MatheoPatinoLoya/Code_TFE_MPL/TFE_Patino_Loya_Matheo.pdf

In.Ra.Ci | Technique de qualification
Avenue Jupiter,188 | Electronique
1190 Bruxelles | Année scolaire 2024-2025

## Radio Réveil

Matheo Patino Loya

Avenue Du Parc 32

1060 Saint-Gilles

Dans un premier temps, j’aimerais remercier tout le personnel e ducatif de l’Inraci que j’ai eu durant mon entre e a cette e cole.

Ensuite, j’aimerais exprimer ma gratitude a M. Mazzeo pour tout le savoir qu’il nous a transmis au fil des deux anne es passe es avec lui.

À mon promoteur M. Kapita, je le remercie de m’avoir tenu la main jusqu’au bout et de m’avoir donne son temps pour mon projet.

En dernier temps, ma famille et mon meilleur ami Gre gory de m’avoir aide et pousse a finir mon projet jusqu’au bout.

## Table des matières

## 1 Introduction

Dans le cadre de mon travail de fin d’e tudes a l’INRÀCI, j’ai choisi de concevoir un radio-re veil en mettant en pratique les compe tences techniques acquises tout au long de ma formation.

Ce projet a pour objectif principal de de velopper de combiner deux fonctionnalite s essentielles :

- La re ception de la radio FM
- Un syste me de re veil fonctionnel

En supple ment, l’appareil affichera l’heure et la date en temps re el, le tout sur un e cran graphique. Des dispositifs tournants permettront de re gler le volume et de changer de station radio. Deux boutons seront ajoute s pour notamment afficher l’heure, la date, le jour, et pour activer, de sactiver l’alarme.

Ce projet m’est venu en te te pendant un cours avec M. Mazzeo et est reste la depuis. La radio est une technologie qui a re volutionne le monde par sa capacite a envoyer et recevoir de l’information sans fil sur de longues distances.
Donc, pour comprendre cette technologie, j’ai eu envie d’en faire mon projet, pour acque rir les bases de la radio. Certes, la radio est un sujet assez complique a comprendre, notamment pour ses aspects techniques, mathe matiques et physiques. Mais cela m’a motive a en faire mon projet.

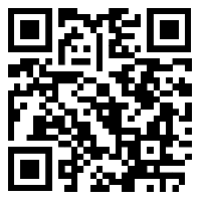
[picture p1: figure]

Lien QR GitHub

## 2 Les caractéristiques

## 2.1 Générale

E cran TFT 2.8" (ILI9341)

2 Encodeur Rotatif (KY-040)

Fusible

2 Bouton Poussoir

Àntenne

Port USB type C

## 2.2 Electrique

Pre cision : ±2 sec/jour

Àutonomie : ~3 ans (pile CR1225)

Fre quence : 80 – 108 MHz

Sensibilite : 1.4 – 1.8 µV

Impe dance antenne : 50 Ω

Sortie : 3.2W

Re solution : 30 crans/tour

Courant de consommation : ~ 200mÀ

Àlimentation : 9V

## 2.3 Mécanique

Mate riaux : Planche de bois Multiplex

Dimension : 13.5 cm x 9.5 cm

## 3 Les Principes mis en jeu

## 3.1 Principe de réception d’un signal FM

Principe du spectre électromagnétique

Pour comprendre comment fonctionne la re ception d’un signal FM, il faut d’abord comprendre les bases du fonctionnement d’une radio.

Le spectre e lectromagne tique, c’est l’ensemble des ondes e lectromagne tiques classe es selon leur fre quence et leur longueur d’onde.
Il existe de nombreux types d’ondes dans ce spectre, les ondes radio, les micro-ondes, la lumie re visible, les rayons X, etc.

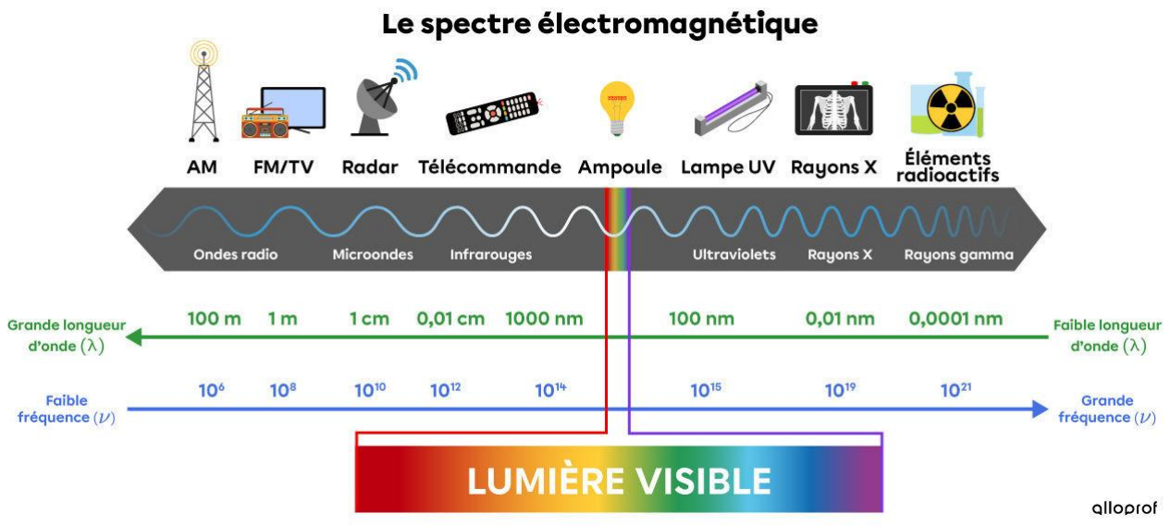
[picture p2: figure]

Source : https://cms.alloprof.qc.ca/sites/default/files/styles/1920w/public/2022-03/is1137-2-spectre-electromagnetique.jpg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 (https://cms.alloprof.qc.ca/sites/default/files/styles/1920w/public/2022-03/is1137-2-spectre-electromagnetique.jpg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) Date de consultation (24/05/25)

Les ondes radio sont utilise es pour transmettre de l’information sans fil gra ce aux ondes e lectromagne tiques. Celles-ci font partie du spectre e lectromagne tique. Sa plage de fre quences va de 3 kHz a 300 GHz.

La vitesse de ces ondes dans le vide est de 300 000 km/s, soit a peu pre s la vitesse de la lumie re.

Pour fabriquer une onde e lectromagne tique, on utilise de l’e lectricite , lorsque que l’on fait circuler du courant e lectrique dans une bobine on cre e un champ magne tique si on inverse le courant e lectrique on inverse le champ magne tique, on le fait varier. C’est ce qui se passe a l’inte rieur d’une antenne, on y fait circuler un courant alternatif qui produit une onde e lectromagne tique.

Maintenant pour transporter la voix gra ce aux ondes e lectromagne tiques ce n’est pas tre s complique , lorsque qu’on parle dans un micro on fait vibrer de l’air a une certaine fre quence, ce qui fait vibrer la membrane du micro, et derrie re cette membrane il y a une bobine qui se de place a l’inte rieur d’un aimant. Les e lectrons de la bobine se mettent en mouvement, on cre e un courant e lectrique de me me fre quence que celle de la voix.

Donc il suffirait de transporter ce courant e lectrique dans l’antenne, ce qui e met des ondes e lectromagne tiques. Malheureusement la voix a une fre quence tre s basse, de 80 Hz a 180 Hz. Pour re gler ce proble me, il suffit de faire circuler du courant alternatif de haute fre quence gra ce a un oscillateur, ce qui cre e une onde porteuse pour transporter la voix.

On me lange le courant e lectrique de haute fre quence avec le signal e lectrique obtenu a l’aide de la voix de basse fre quence. On me lange un courant de haute fre quence (onde porteuse) avec le signal audio basse fre quence (voix) pour produire un signal FM. Du coup, l’antenne va transmettre une onde e lectromagne tique de haute
fre quence module e par la voix (FM).

Schéma

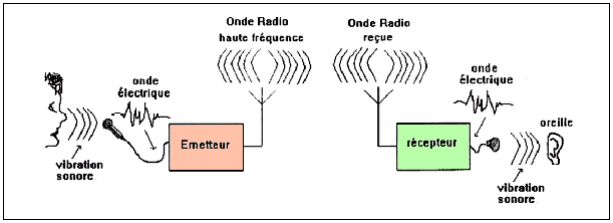
[picture p3: figure]

Source : https://i0.wp.com/promocom.r-e-f.org/wp-content/uploads/2015/11/10_1.gif Date de consultation (19/05/25)

Pour la re ception d’un signal FM, l’antenne re cupe re l’onde e lectromagne tique e mise, on obtient donc un courant alternatif de haute fre quence. Le proble me, c’est que les
fre quences sont tellement grandes, l’oreille humaine peut entendre de 20 Hz a 15 kHz, ce qui est trop faible pour entendre les hautes fre quences.
Pour re gler ce proble me, on va utiliser un de modulateur pour re cupe rer que le signal de la voix et ainsi couper les hautes fre quences, et avec ce signal on peut ainsi alimenter le haut-parleur et e couter la voix e mise au de but.

Les ondes e lectromagne tiques transportent le signal audio sous forme de variations de fre quence, qui sont capte es par l’antenne d’un re cepteur. Ce signal est ensuite de module pour enlever les variations de fre quence et juste re cupe rer le signal e lectrique de la voix pour ensuite l’entendre sur un haut-parleur.

Principe de la Fm et Am

De plus, la radio repose sur deux techniques principales de modulation pour transmettre le son la modulation d’amplitude (ÀM) et la modulation de fre quence (FM).

Ces deux me thodes influencent la qualite du son et la fiabilite de transmission.
Àvec la modulation d’amplitude (ÀM), c’est l’amplitude qui varie en fonction du signal audio. Elle permet une large porte e de diffusion.

À l’inverse, la modulation de fre quence (FM) c’est la fre quence qui varie, tout en gardant une amplitude constante.

Source :https://th.bing.com/th/id/R.7a028524f09b79cb0bfb383d5a6a4df5?rik=r%2fPeYTAIPuPyzg&riu=http%3a%2f%2felect ronics-club.com%2fwp-content%2fuploads%2f2020%2f09%2fAM-vs-FM.jpg&ehk=FTt6Wd4UWJcLtHDBvMvX2aBUBDZga1KqjhUlGCT3seI%3d&risl=&pid=ImgRaw&r=0 (https://th.bing.com/th/id/R.7a028524f09b79cb0bfb383d5a6a4df5?rik=r%2fPeYTAIPuPyzg&risl=&pid=ImgRaw&r=0)

Date de consultation (19/05/25)

Avantages de la FM
La modulation de fre quence (FM) offre une qualite sonore nettement supe rieure. En modulant la fre quence de l’onde porteuse pluto t que son amplitude, la FM re duit conside rablement les interfe rences et parasites, ce qui donne un son de meilleure qualite .

Inconvénients de la FM
Cependant, la porte e des e missions FM est limite e, ce qui a pour effets de restreint sa distance de porte e

Avantages de l’AM
À l’inverse, la modulation d’amplitude (ÀM) permet une porte e bien plus e tendue.

Inconvénients de l’AM
Toutefois, la modulation ÀM est plus vulne rable aux parasites et aux distorsions, ce qui peut de grader la qualite sonore.

## 3.2 Principe d’amplificateur Classe D

L’amplificateur de classe D est un type d’amplificateur audio efficace, souvent utilise dans les appareils portables, les syste mes audio compacts, il fonctionne selon un principe de commutation a haut fre quence, ce qui permet de re duire
conside rablement les pertes d’e nergie.

Sche ma bloc

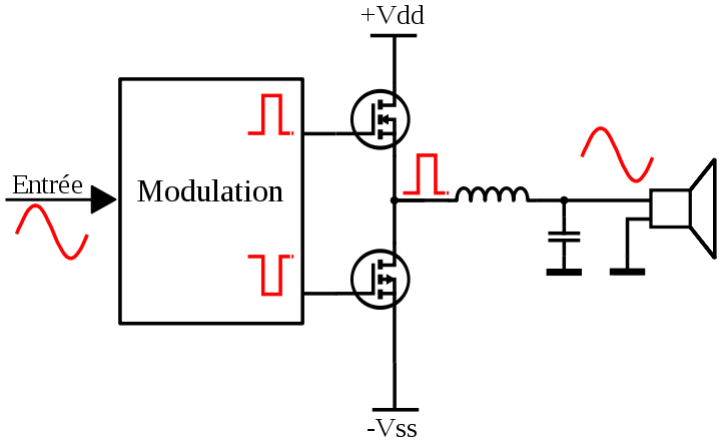
[picture p4: figure]

Source : https://jaazz.files.wordpress.com/2011/01/classe_d.png?w=712 Date de consultation (20/05/25)

Fonctionnement de l’amplificateur de classe D

L’amplificateur de classe D transforme le signal audio en un signal a impulsions (PWM), gra ce a un modulateur.

Ces impulsions sont envoye es a des transistors qui fonctionnent comme des interrupteurs ils sont soit ouverts, soit ferme s, avec une alimentation syme trique.

Ensuite, un filtre passe-bas, compose d’une bobine et d’un condensateur, e limine les hautes fre quences lie es a la fre quence de de coupage.

Àfin de permettre de reconstituer le signal audio d’origine, ce signal sera enfin envoye dans un haut-parleur.

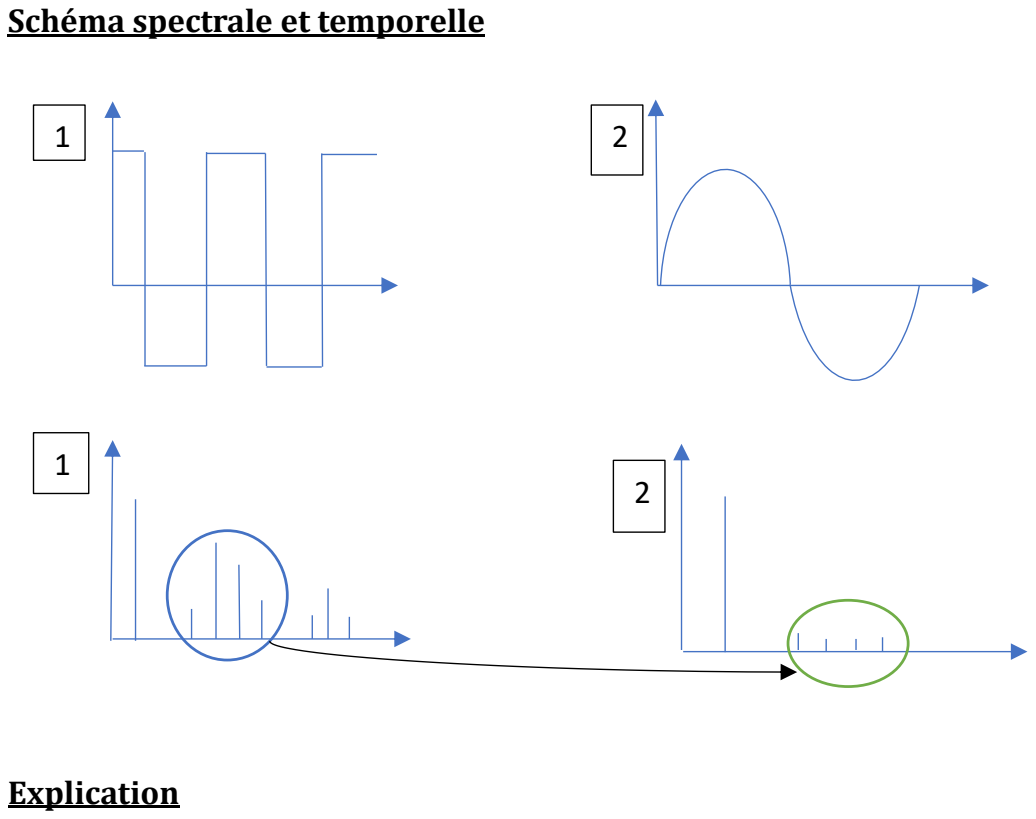
[picture p5: figure]
Schéma spectrale et temporelle; Explication

Sur le premier graphique, nous avons un signal nume rique. Juste en dessous, c’est sa repre sentation spectrale. On remarque qu’on a une fondamentale, celle-ci correspond au signal audio. À la suite de la fondamentale suivent les harmoniques.
Elle correspond a la fre quence de de coupage, ce qui, ensemble, cre e un signal PWM ou MLI qui est module par rapport au signal audio d’origine.

Sur le deuxie me graphique, on a filtre le signal pour retirer les harmoniques de la
fre quence de de coupage afin de n’avoir que le signal audio d’origine. Celle-ci est repre sente e par un sinus.

On remarque que, dans la repre sentation spectrale, il reste encore des harmoniques. Cela est du au filtre, car il n’est pas parfait et n’enle ve pas toutes les harmoniques. Cela peut causer de la distorsion dans le signal d’origine, soit une variation ou de formation du sinus.

Avantage
Son plus gros avantage est son rendement, qui est du au transistor en commutation. Lorsque celui-ci est bloque , sa consommation est de 0 car Ic = 0. À l’inverse, quand le transistor est sature , sa consommation est de 0 car VCE = 0 (0,2 V), ce qui e vite la dissipation thermique ou presque.
Moins encombrant, parfait pour des petits dispositifs elle occupe le moins d’espace possible, avec une bonne puissance de sortie pour sa taille.

Inconvénient
Distorsion due aux harmoniques qui passent car le filtre n’est pas parfait.
Un des plus grands inconve nients, c’est que l’amplification de pend de l’alimentation.

Schéma

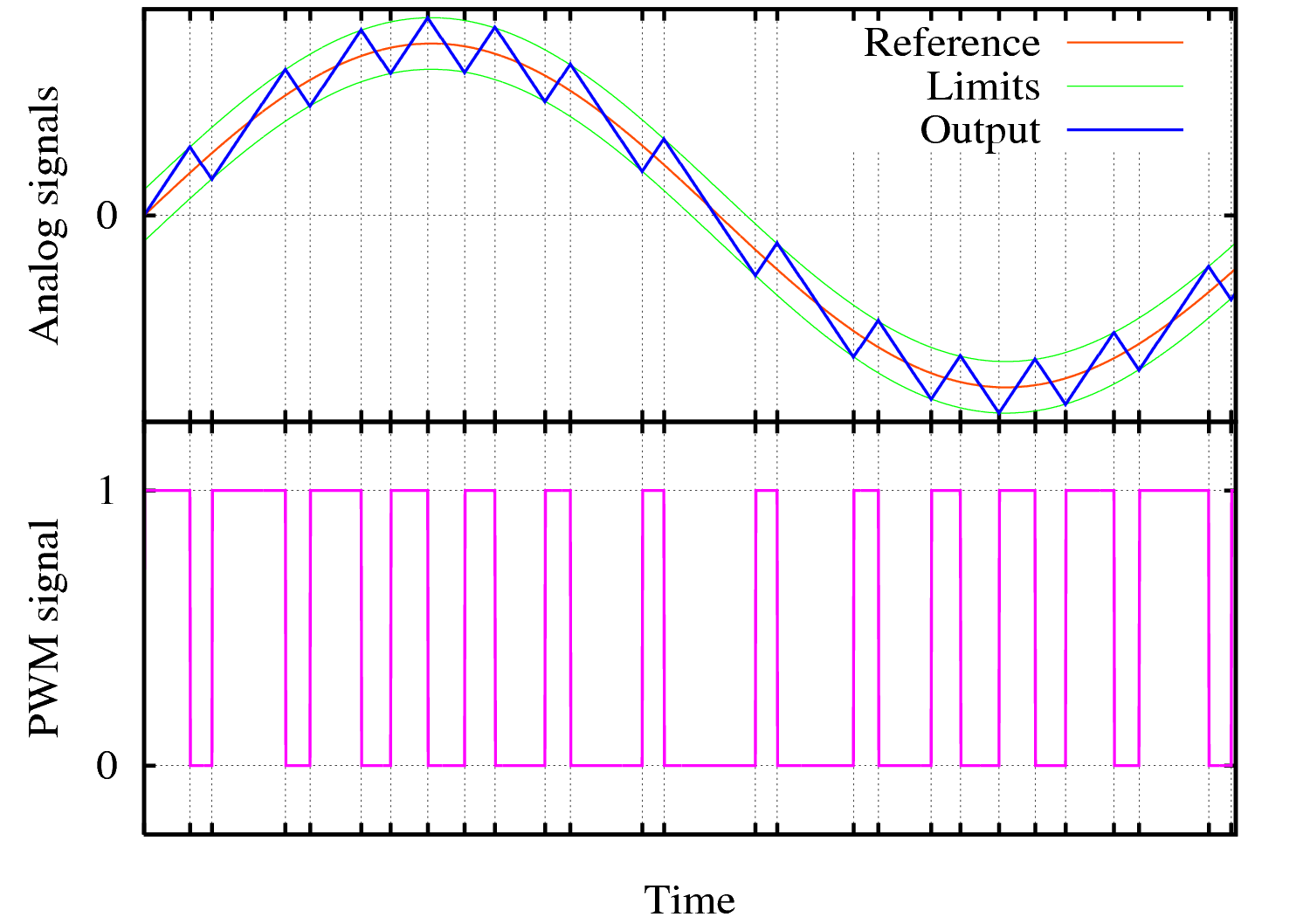
[picture p6: figure]

Source : https://upload.wikimedia.org/wikipedia/commons/e/e2/Delta_PWM.png Date de consultation (20/05/25)
Analyse

Sur l’image, on voit en haut un signal analogique, un sinus, et une dent de scie qui sert de re fe rence. Gra ce a cette re fe rence, le signal PWM est module par rapport au sinus d’origine. La sortie alterne entre impulsions 1 et 0. Le rapport cyclique du signal
PWM varie pour suivre la forme du sinus, ce qui permet de conserver l’information du signal analogique.

## 4 Le Schéma bloc

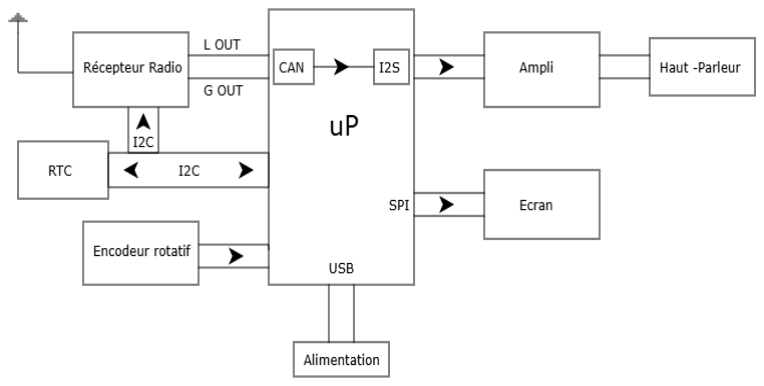
[picture p7: figure]

Explication

Récepteur radio
Ce bloc capte les signaux radio analogiques reçus par l’antenne et les convertit en signaux audio analogiques. Il reçoit un signal analogique provenant de l’antenne et fournit en sortie un signal audio analogique pour le microprocesseur.

RTC
Le bloc RTC conserve l’heure, la date et le jour, me me lorsque l’appareil est e teint, gra ce a une pile interne. Il communique avec le microprocesseur via un bus I2C bidirectionnel, e changeant des donne es nume riques pour fournir ou recevoir des informations.

Encodeur rotatif
L’encodeur rotatif permet a l’utilisateur d’interagir avec la radio, par exemple pour changer le volume ou la station. Il ge ne re des impulsions nume riques en sortie.

Alimentation
L’alimentation fournit une tension continue stable et le courant ne cessaire pour faire fonctionner tous les blocs.

Écran
L’e cran reçoit des donne es et des commandes nume riques envoye es par le microprocesseur via un bus SPI. Son ro le est d’afficher les informations provenant des diffe rents blocs, comme l’heure, la station radio ou le volume.

Amplificateur audio
L’amplificateur reçoit un signal audio nume rique via le bus I2S, puis amplifie ce signal audio pour pouvoir alimenter le haut-parleur. Sa sortie est un signal audio analogique amplifie .

Haut-parleur
Le haut-parleur convertit le signal audio e lectrique amplifie en ondes sonores audibles. Il reçoit en entre e un signal analogique amplifie et produit un son audible en sortie.

Microprocesseur (µP)
Le microprocesseur reçoit le signal audio analogique provenant du re cepteur radio et le convertit en signal nume rique gra ce a un convertisseur analogique-nume rique (ÀDC) de 16 bits. Il ge re la communication avec le RTC via le bus I2C. Il envoie le signal audio nume rique a l’amplificateur via le protocole I2S, et communique avec l’e cran par SPI pour afficher les informations. Enfin, il lit les impulsions nume riques envoye es par l’encodeur rotatif. Les entre es du microprocesseur sont donc a la fois analogiques (audio) et nume riques (encodeur, RTC), tandis que ses sorties sont nume riques (audio via I2S, commandes pour l’e cran via SPI).

## 5 L’étude détaillée et les mesures

## 5.1 Schéma complet

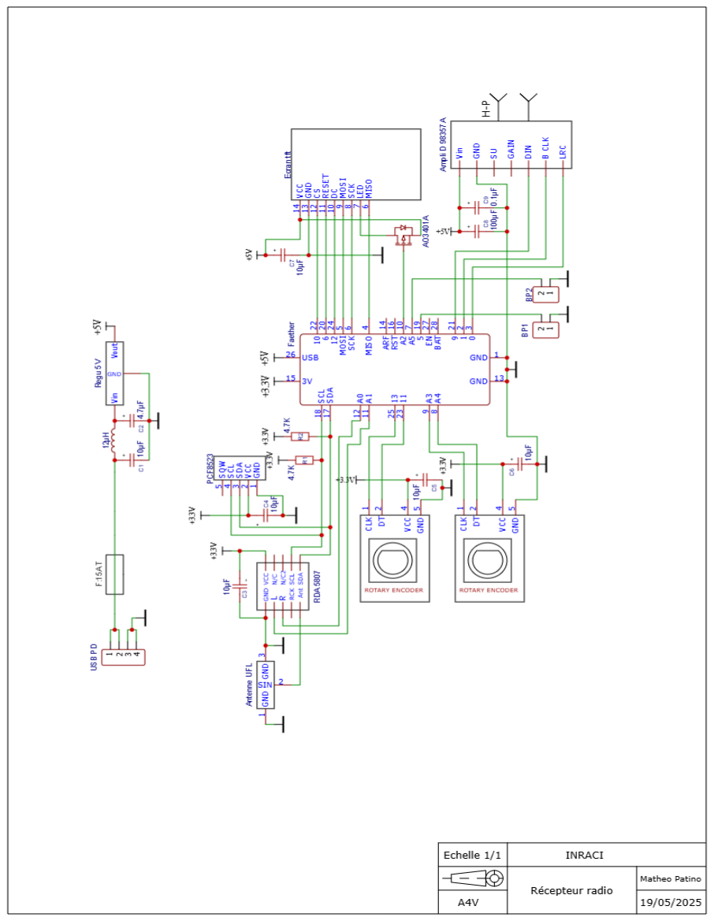
[picture p8: figure]

## 5.2 Etude du Max98357A

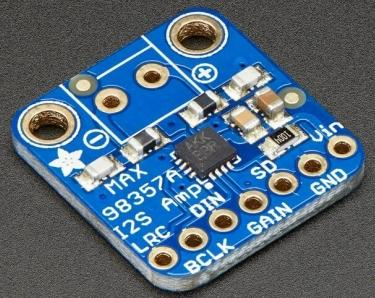
[picture p9: figure]

Source : https://cdn.myikas.com/images/8b57d900-7b49-4cf7-810a-401e00bd0425/25604e38-825c-41f1-b189-39866da1e7f8/image_900.webp (https://cdn.myikas.com/images/8b57d900-7b49-4cf7-810a-401e00bd0425/25604e38-825c-41f1-b189-39866da1e7f8/image_900.webp) Date de consultation (20/05/25)

Spécifications

Puissance de sortie : 3,2 W a 4 Ω, 10 % THD, 1,8 W a 8 Ω, 10 % THD, avec alimentation 5V

Fre quences d’e chantillonnage I2S de 8kHz a 96kHz

Cinq gains se lectionnables par broche : 3 dB, 6 dB, 9 dB, 12 dB, 15 dB

Protection contre l’arre t thermique

Lien QR Spécification

Schéma

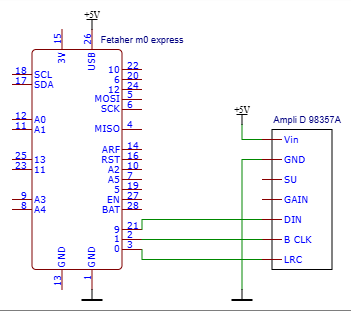
[picture p10: figure]

Rôle des signaux

LRC (Left/Right Clock)
C’est la broche qui indique a l’amplificateur quand les donne es sont pour le canal gauche et quand elles sont pour le canal droit le 1 pour le canal droit et 0 pour le canal gauche.

BCLK (Bit Clock)
Elle sert a indiquer a l’amplificateur quand lire les donne es sur la broche de donne es, actif sur flanc montant, synchronise les bits de donne es.

DIN (Data In)
Cette entre e contient les donne es audios nume riques pour les canaux gauche et droit.

GÀIN (Gain Select)
Celle-ci permet de se lectionner le gain de l'amplificateur, c'est-a -dire le niveau d'amplification du signal audio.

SD (Shutdown)
Utilise e pour le mode d’arre t, mais elle est e galement utilise e pour de finir le canal de sortie.

Datasheet

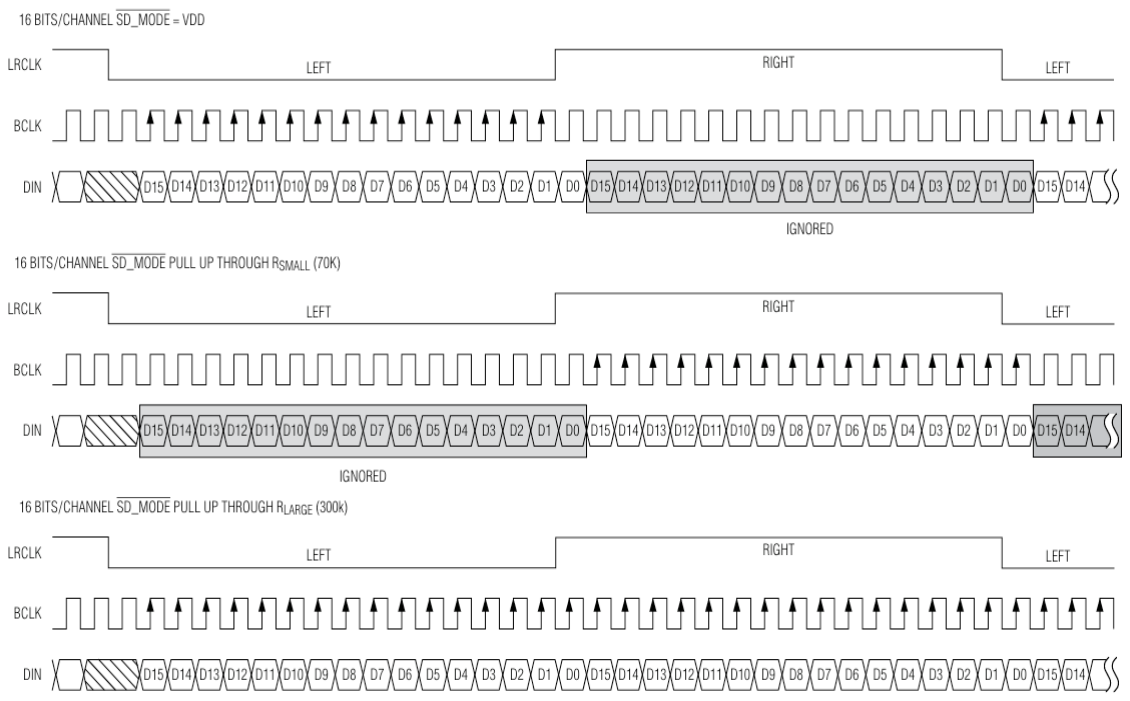
[picture p11: figure]

Analyse

Sur cette image, on constate que trois signaux sont pre sents : LRC, BCLK, DIN. Chacun d’entre eux correspond bien au ro le qui lui a e te attribue sur 16 bits. De plus, la synchronisation se fait sur les flancs montants.

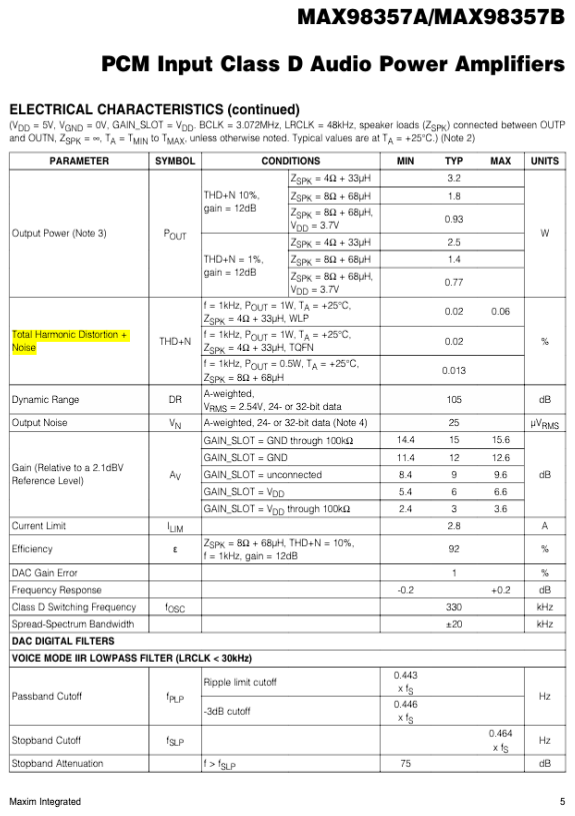
[picture p12: figure]

Schéma bloc interne de l’amplificateur classe D

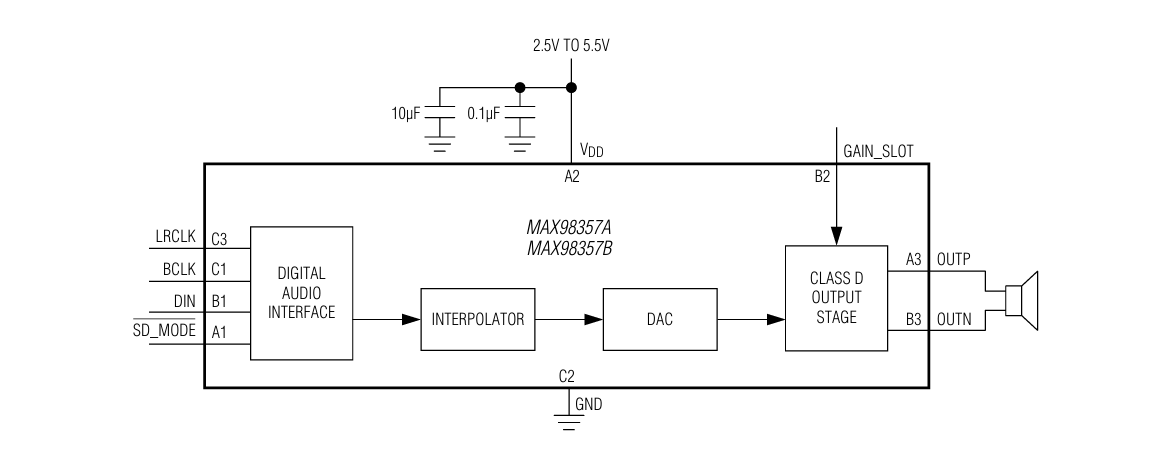
[picture p13: figure]

Source https://cdn-shop.adafruit.com/product-files/3006/MAX98357A-MAX98357B.pdf Date de consultation (12/11/2025)

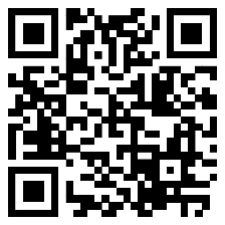
[picture p14: figure]

Lien Datasheet

Explication des blocs

Digital Audio Interface
C'est le premier bloc du circuit. Il reçoit le signal audio nume rique et le pre pare pour traitement.

Interpolateur
Il ame liore la qualite du signal nume rique avant qu'il ne soit converti en signal analogique.

DAC (Digital-to-Analog Converter)
Ce composant transforme le signal audio nume rique (0 et 1) en un signal analogique continu.

Étape de sortie de classe D
Àmplifie le signal analogique pour qu'il soit suffisamment puissant pour faire fonctionner un haut-parleur.
Les sorties OUTP (À3) et OUTN (B3) envoient ce signal amplifie vers le haut-parleur connecte .

GAIN_SLOT
Permet de re gler l’amplification gra ce a la configuration du gain.

Alimentation
Fournit l’e nergie au circuit entre 2,5 V et 5,5 V.

Programme Test

#include <I2S.h>

const int amplitude = 500; // Amplitude du signal audio short sample = amplitude; // Valeur actuelle de l'échantillon

void setup() {
Serial.begin(115200);
if (!I2S.begin(I2S_PHILIPS_MODE, 44100, 16)) { Serial.println("Erreur I2S !"); while(true);
}
}

void loop() {
I2S.write(sample); | // Envoi sur canal gauche
I2S.write(sample); | // Envoi sur canal droit
sample = -sample; | // Inversion pour générer une onde carrée
delayMicroseconds(1136); // Pause pour fréquence ~440 Hz
}
Source : ChatGPT (https://chatgpt.com/) date de consultation (20/11/2025)
Explication

Ce programme cre e un son (la), l’amplitude de ce signal est de 500, et on l’envoie dans les canaux gauche et droit de l’I2S. Comme on a que du positif, on ne peut pas avoir de son, alors on cre e du -500 pour avoir une oscillation.
La fre quence qu’on veut est 440 Hz, donc la pe riode d’un cycle complet est d’environ 2270 microsecondes. Dans le code, on fait un de lai de 1136 microsecondes, car c’est la moitie de la pe riode puisque qu’il alterne entre -500 et +500.

NT : Ce code ne s’applique pas aux mesures ci-dessous.

5.2.1 Mesure du MAX98357A

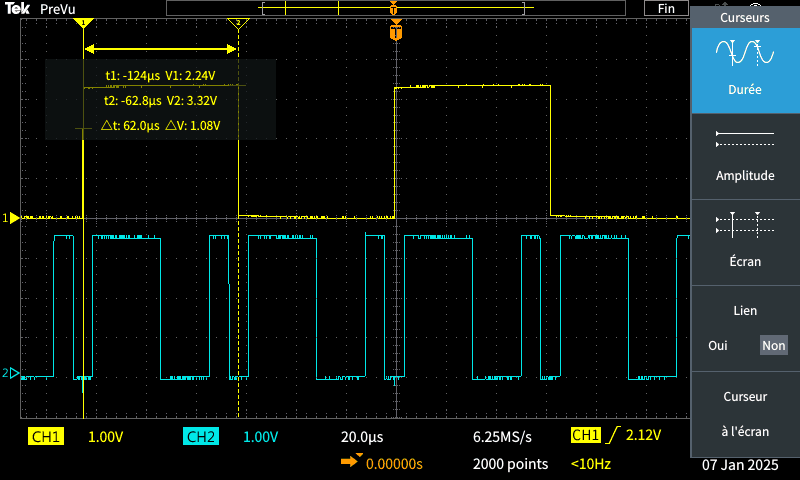
[picture p15: figure]

En jaune : LRC

En bleu : DIN

La largeur d’impulsion est de 62µs pour le canal droit

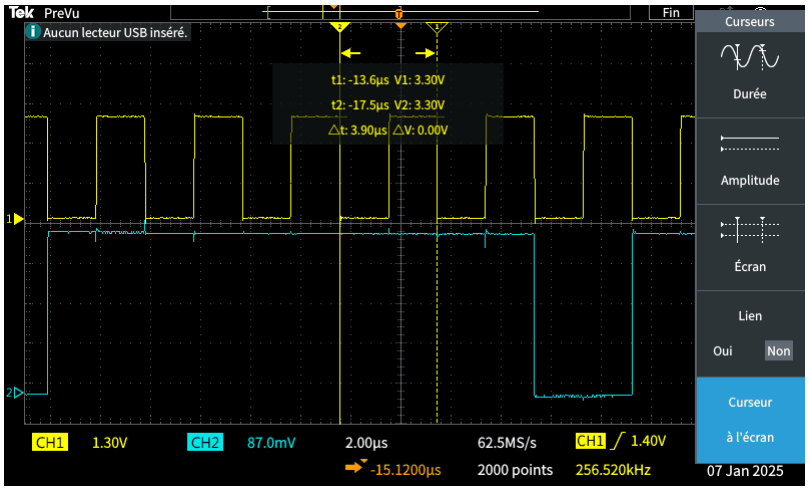
[picture p16: figure]

En jaune : Bclk

En bleu : DIN

BCLK a une fre quence de 256,520 KHz, la dure e d’un bit dure 3.90µs

Analyse

Le signal BCLK permet d’envoyer chaque bit au bon moment, le signal audio transmis est une onde carre e qui alterne entre +500 et −500 a chaque demi-pe riode, et comme chaque valeur est envoye e deux fois (gauche puis droite), le son est le me me des deux co te s.

On voit aussi sur le canal CH1 (jaune) la pe riode BCLK mesure e a 3,90 µs donc la
fre quence est bien 1 / 3,90 µs ≈ 256,41 kHz, et sur CH2 (bleu) on voit le motif binaire 01010101 typique d’une onde carre e nume rique, avec le signal LRC qui est bas pour le canal gauche et haut pour le canal droit.

Donc en conclusion, les signaux mesure s montrent que la transmission I2S fonctionne bien. De plus, la datasheet nous permet de ve rifier l’allure des signaux qui sont en cohe rence avec les mesures faites sur l’ampli MÀX98357À.

## 5.3 Etude du RDA5807M

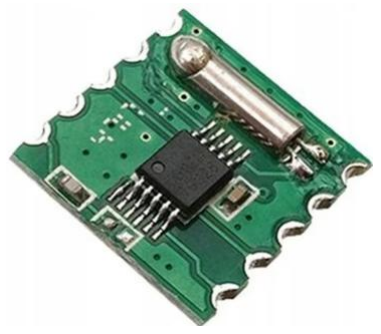
[picture p17: figure]

Source: https://s13emagst.akamaized.net/products/51986/51985910/images/res_26ceb7fe6f25d598bae5399645cb6c0b.jpg Date de consultation (20/05/25)

Spécifications

Type : Re cepteur FM ste re o

Fre quence : 50 a 115 MHz

Àlimentation : 1.8 V a 3.6 V

Courant de consommation : 20mÀ

Sortie audio : Ànalogique ste re o (L/R)

Interface : I2C

Impe dance d’entre e : 50 Ω

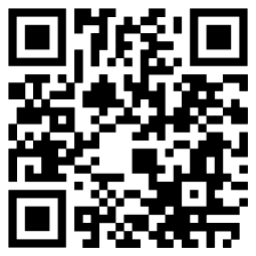
[picture p18: figure]

Lien QR spécifications

Schéma

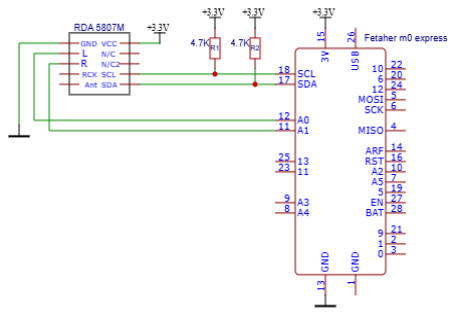
[picture p19: figure]

Rôle des signaux

SCL (Serial Data Line) : SCL est la ligne d’horloge elle est utilise e pour synchroniser tous les transferts de donne es sur le bus I2C sur flanc montant

SDÀ (Serial Clock Line) : SDÀ est la ligne de donne es

L : Sortie audio canal gauche connecter au µp pour une conversion Ànalogique nume rique

R : Sortie audio canal droit connecter au µp pour une conversion Ànalogique

Nume rique.

R1 et R2 : les re sistances de pull-up assure quel soit au niveau logique haut pour une communication stable

N/C (no connect) : pas de connexion

Ànt : Broche du signal analogique de l’antenne

Programme Test

include <Arduino.h>
#include <Wire.h>

#include <radio.h>

#include <RDA5807M.h>

// ----- Paramètres fixes -----
#define FIX_BAND RADIO_BAND_FM ///< La bande radio utilisée par ce programme est la FM.

#define FIX_STATION 8930 | ///< La station qui sera syntonisée est

89.30 MHz.
#define FIX_VOLUME 10 | ///< Le volume défini par ce programme est

de niveau 10.

RDA5807M radio; // Création d'une instance de la classe pour la puce RDA5807M

/// Configuration de la radio FM
/// avec affichage des informations de débogage sur le port série void setup() {

// Configuration FM pour l'Europe
radio.setup(RADIO_FMSPACING, RADIO_FMSPACING_100); // Espacement des stations (Europe)
radio.setup(RADIO_DEEMPHASIS, RADIO_DEEMPHASIS_50); // Déaccentuation du signal (Europe)

// Initialisation de la puce radio
if (!radio.initWire(Wire)) { Serial.println("Aucune puce radio détectée."); delay(4000);
};

// Appliquer les paramètres fixes de la radio radio.setBandFrequency(FIX_BAND, FIX_STATION); radio.setVolume(FIX_VOLUME); radio.setMono(false);
radio.setMute(false);
} // Fin de setup

void loop() {

}

Source : GitHub - mathertel/Radio : Une librairie Arduino pour contrôler les puces radio FM comme SI4703, SI4705, RDA5807M, TEA5767. (https://github.com/mathertel/Radio) Date de consultation (20/11/25)

Datasheet

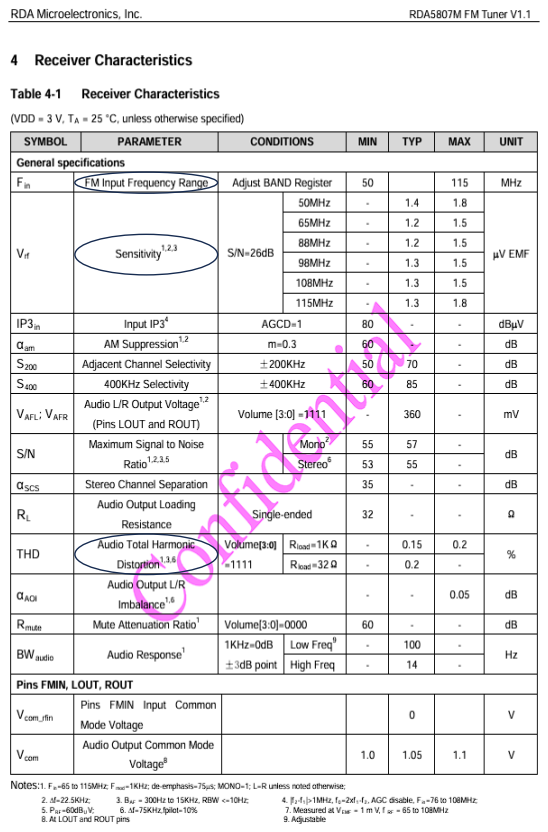
[picture p20: figure]

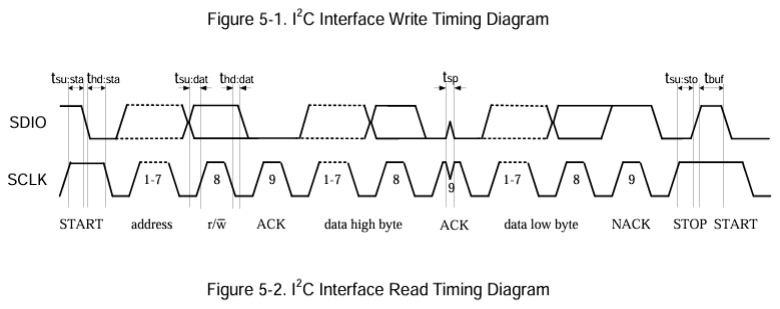
[picture p21: figure]
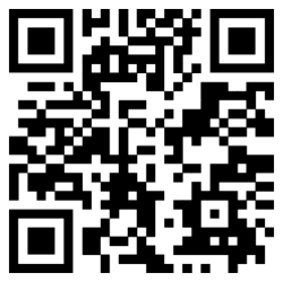
[picture p22: figure]

Lien QR datasheet

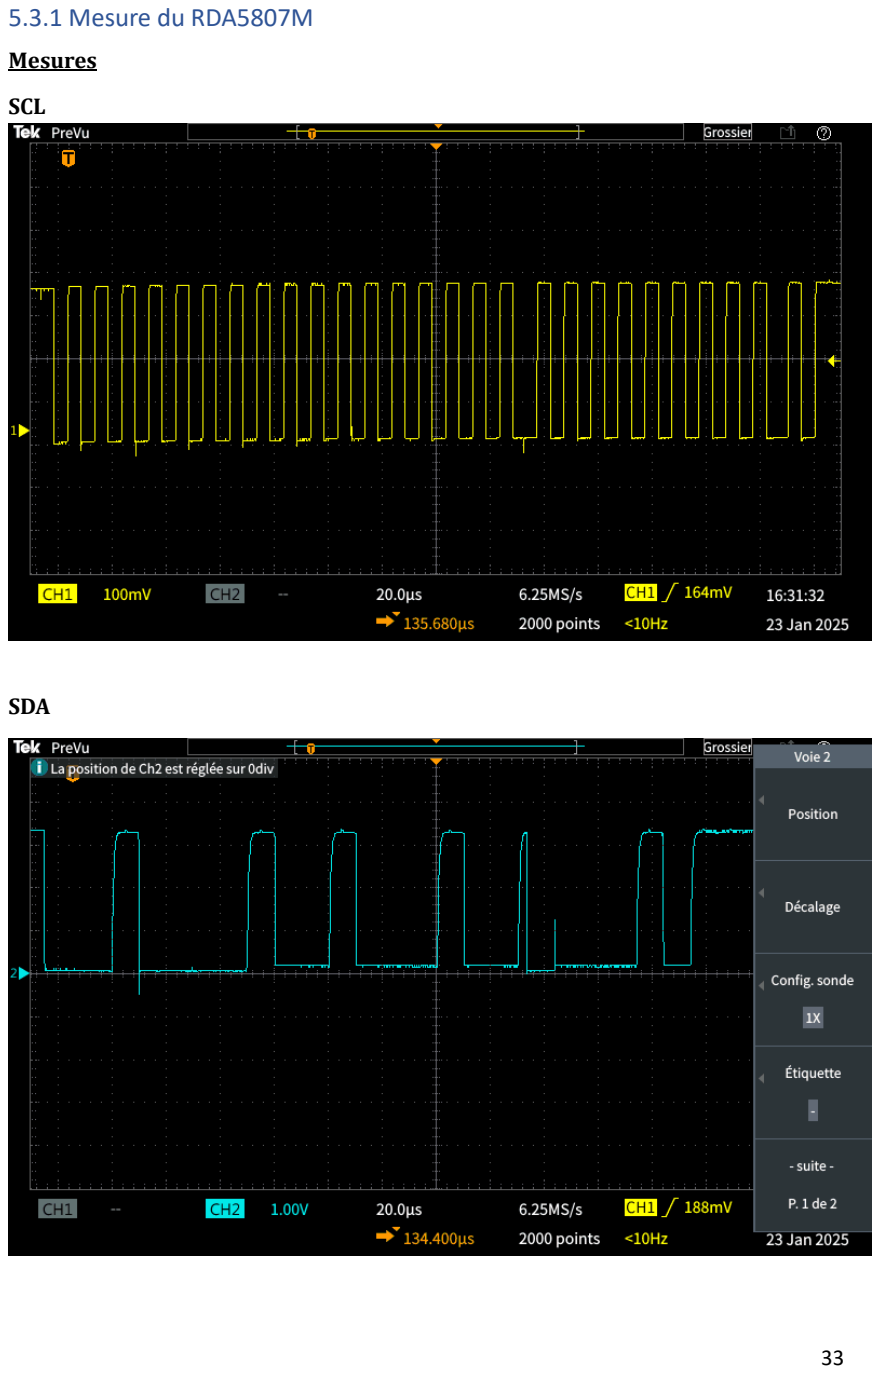
[picture p23: page 34]

5.3.1 Mesure du RDA5807M

Mesures

SCL

SDA

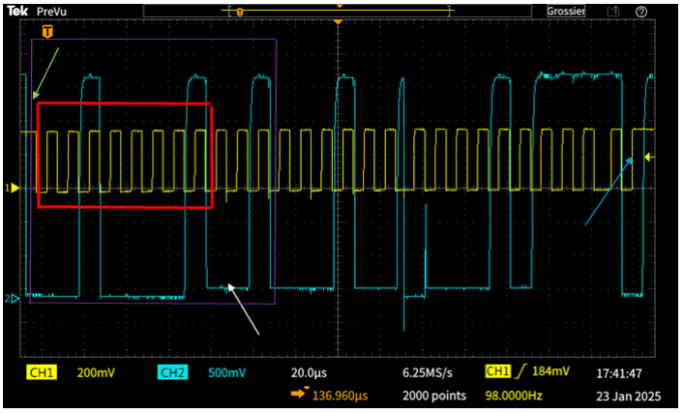
[picture p24: figure]

Analyse

Dans cette trame, la condition de de part est pressante, adresse, R/W, ÀCK, condition d’arre t.

En vert, la condition de de part
En rouge, l’adresse envoye e bit par bit En blanc, le R/W et ÀCK
En bleu, la condition d’arre t
En mauve, le premier octet

L'adresse en binaire correspond a 0b0010001, contient 7 bits ce qui veut dire que le 8e et 9e bits correspondent a R/W et ÀCK qui eux sont a 0. D’un co te , cela signifie que la Feather envoie des donne es (e criture) au RDÀ5807 (module radio) et puisque ÀCK est a 0, cela confirme que l’esclave a bien reçu l’info.

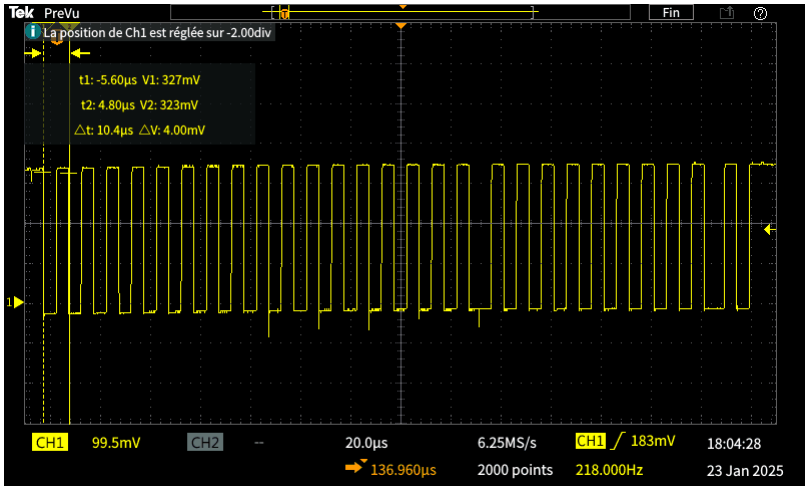
[picture p25: figure]

Dure e d’un bit

Δt=10.4µs

Baud rate

1/ Δt = 1/10,4×10−6 s = 96 154 bauds

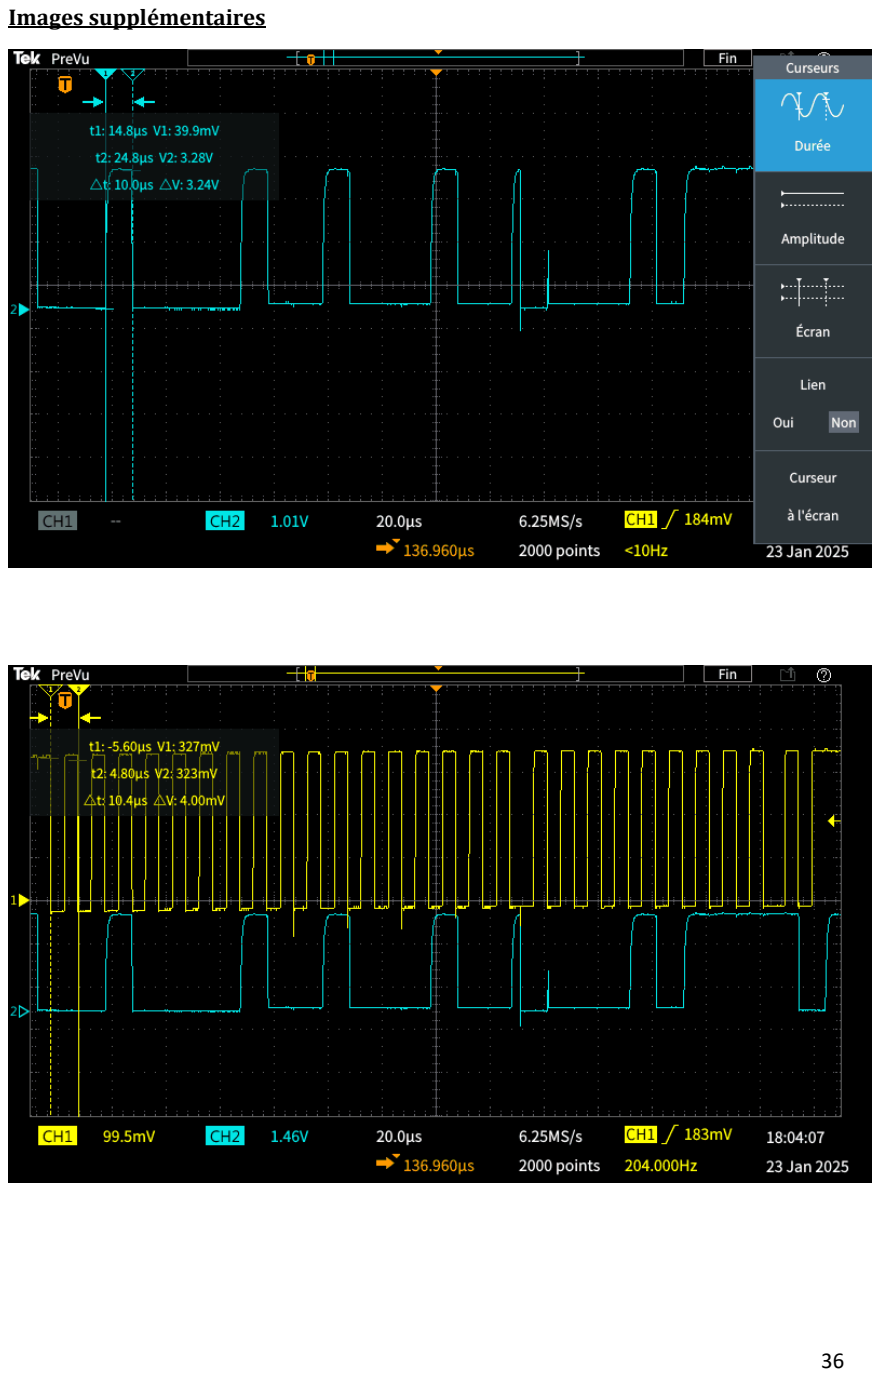
[picture p26: page 37]

Images supplémentaires

## 5.4 Bus I2C

Le I²C (Inter-Integrated Circuit) est un protocole de communication de veloppe par Philips au de but des anne es 1980, c’est un bus se rie synchrone destine a permettre a plusieurs circuits inte gre s nume riques “pe riphe riques” de communiquer avec un ou plusieurs “contro leurs”.

Maî tre (Master) : Contro le la communication, en ge ne rant les signaux d'horloge et en initiant les transferts de donne es, “contro leurs”.
Esclaves (Slaves) : Re pondent aux commandes du maî tre. Un bus I2C peut avoir plusieurs esclaves connecte s a une paire de lignes SDÀ et SCL, “pe riphe riques”.

Schéma

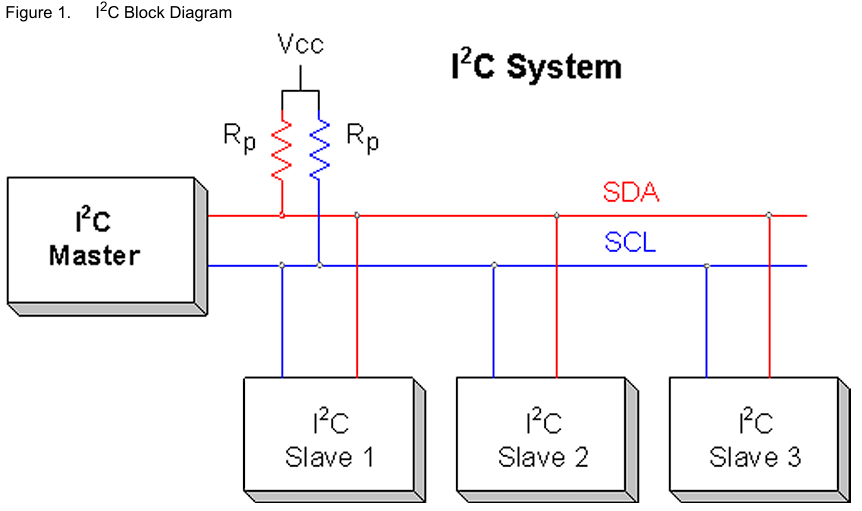
[picture p27: figure]

Configuration basic du I2C, un maitre peut avoir plusieurs esclaves de plus seul 2 lignes de communication sont ne cessaires.

Source : I2Cm.dita (https://www.infineon.com/dgdl/Infineon-I2Cm_001-13676-Software+Module+Datasheets-v01_05-EN.pdf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) date de consultation (2/05/25)

Lien QR Datasheet

Schéma

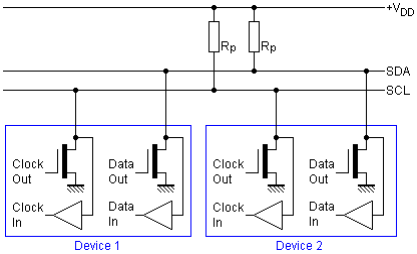
[picture p28: figure]

Source : https://www.lammertbies.nl/picture/i2c_interface.png (consultée le 2/05/25)
Explication

Le bus I2C fonctionne gra ce aux transistors qui sont utilise s pour la communication, contro lant ainsi la connexion ou de connexion des lignes de donne es SCL et SDÀ, des interrupteurs ouverts ou ferme s, car en l’absence de communication, les lignes sont obligatoirement tire es vers le haut.
Pour qu’une transmission se fasse, il faut que les transistors soient ferme s pour tirer la ligne vers le bas.
Les pull-up maintiennent les lignes a un niveau haut, cela empe che les lignes de rester a un niveau inde termine . Elles sont tre s importantes pour avoir une communication stable.
Quand les donne es sont envoye es en me me temps 1 ou 0, c’est le 0 qui est prioritaire car le 1 est re cessif et le 0 dominant.

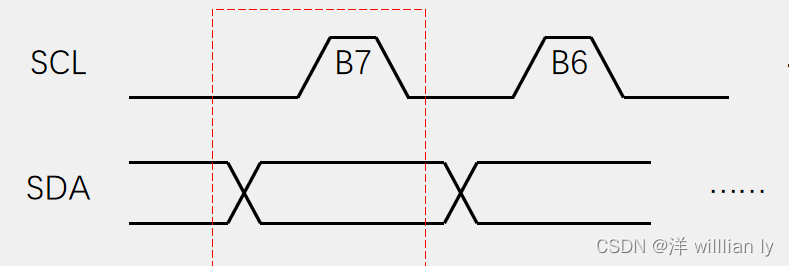
[picture p29: figure]

Source : https://img-blog.csdnimg.cn/5b8198682abf41e4a44646eb8f2e6eb0.png Date de consultation (2/05/25)
SCL (Serial Clock Line) : SCL est la ligne d’horloge elle est utilise e pour synchroniser tous les transferts de donne es sur le bus I2C sur flanc montant, scl est ge ne re par le maitre.

SDÀ (Serial Data Line) : SDÀ est la ligne de donne es elle transporte les bits de donne es envoye s ou reçus entre l’esclaves et le maitre

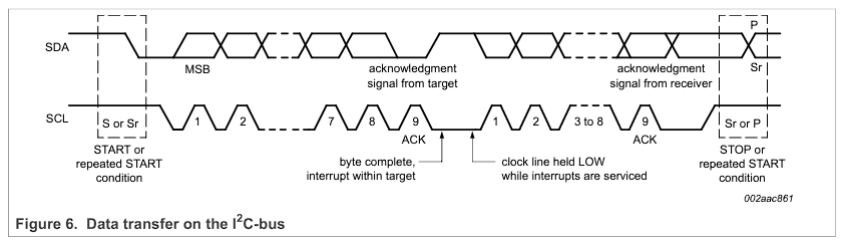
[picture p30: figure]

Source : I2C-bus specification and user manual (https://www.nxp.com/docs/en/user-guide/UM10204.pdf) date de consultation (2/05/25)

Lien QR Datasheet

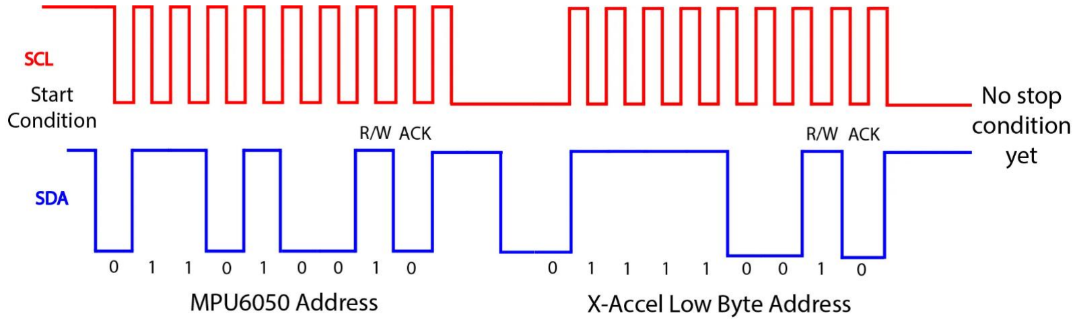
[picture p31: figure]

Source : https://i2.wp.com/www.teachmemicro.com/wp-content/uploads/2018/04/MPU6050-I2C-1.jpg?ssl=1

Date de consultation (2/05/25)
Explication

Une trame de donne e commence toujours par une condition de de part envoye e par le maî tre pour signaler le de but de la communication. Ensuite, l’adresse est envoye e bit par bit, suivie d’un bit de lecture ou e criture (ex : Lecture = lire des donne es d’un capteur ou de tempe rature. E criture = e crire des donne es, configuration d’un capteur ou de tempe rature), suivie de l’accuse de re ception ÀCK pour confirmer que l’adresse a bien e te reçue, et pour finir la condition d’arre t pour arre ter la transmission de donne es. Tout ce cycle correspond a 1 octet.

Condition de de part : commence quand la ligne SDÀ passe de haut a bas lorsque la ligne SCL est toujours en haut.

Condition d’arre t : commence quand la ligne SDÀ passe de bas a haut lorsque la ligne SCL est toujours en haut.

Lecture et e criture : le bit de lecture est a 1, ce qui veut dire que le maî tre veut lire les donne es de l’esclave. Le bit d’e criture est a 0, ce qui veut dire que le maî tre veut e crire dans la donne e de l’esclave.

ÀCK : confirme la re ception de donne e entre le maî tre et l’esclave, il garantit la fiabilite des donne es entre les deux.

## 5.5 L’encodeur rotatif

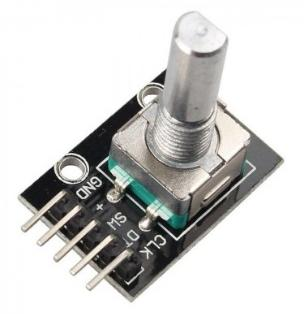
[picture p32: figure]

Source : https://arduinko.ru/image/cache/catalog/Enkoderpotenciometr_rotornyy_KY-040-1000x1340.jpg

Date de consultation (20/05/25)

Spécifications

Type : Codeur rotatif incrémental

Tension d’alimentation : 5v

Courant : 10 mA

Cycles par tour 30

Nombre de battements par tour : 20

Dimensions : 20 x 30 x 30 mm

Poids : 10g

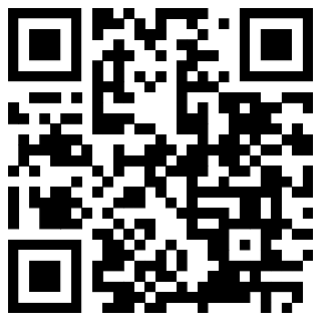
[picture p33: figure]

Lien QR spécification

Schéma de principe

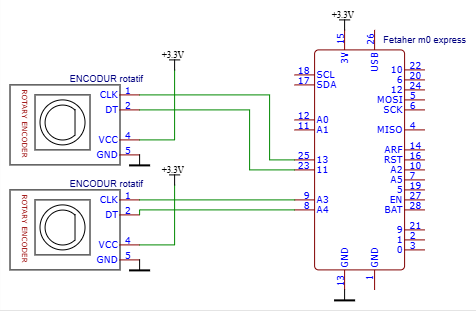
[picture p34: figure]

Rôle des signaux

CLK : Signal d’impulsion d’horloge

DT : Signal d’impulsion de donnée

VCC : alimentation

GND : masse

Principe de fonctionnement

L’encodeur KY-040 est un syste me d’encodage incre mental. Quand on tourne, les broches À (CLK) et B (DT) envoient des signaux carre s qui passent de l’e tat haut a l’e tat bas.
Ces signaux s’alternent au fur et a mesure qu’on fait tourner l’encodeur en fonction du sens dans lequel on tourne : l’un des signaux change avant l’autre pour que le microcontro leur capte le sens de rotation. CLK et DT doivent e tre en quadrature, ce qui veut dire de phase s de 90°.

Schéma

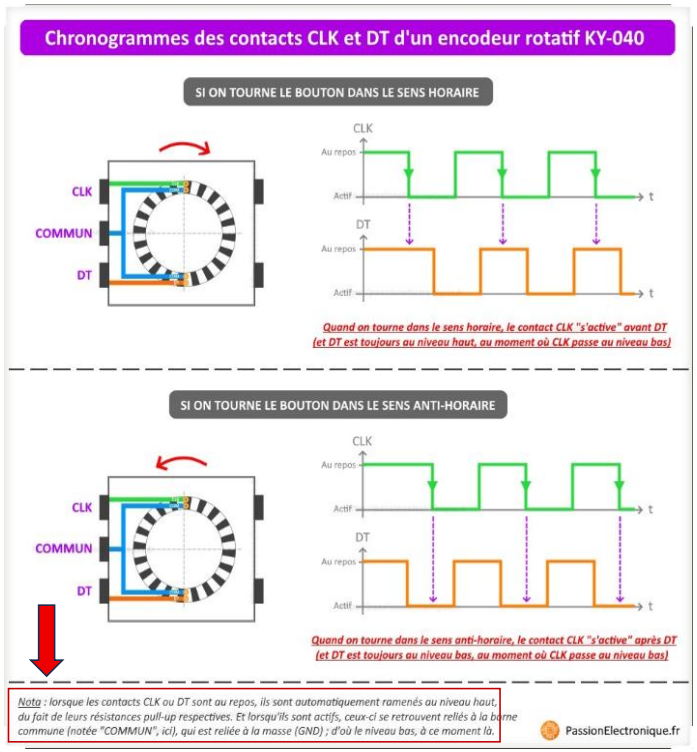
[picture p35: figure]

Source : Encodeur rotatif : fonctionnement + exemples de code arduino (https://passionelectronique.fr/encodeur-rotatif-incremental-mecanique/) Date de consultation (28/1/2025)

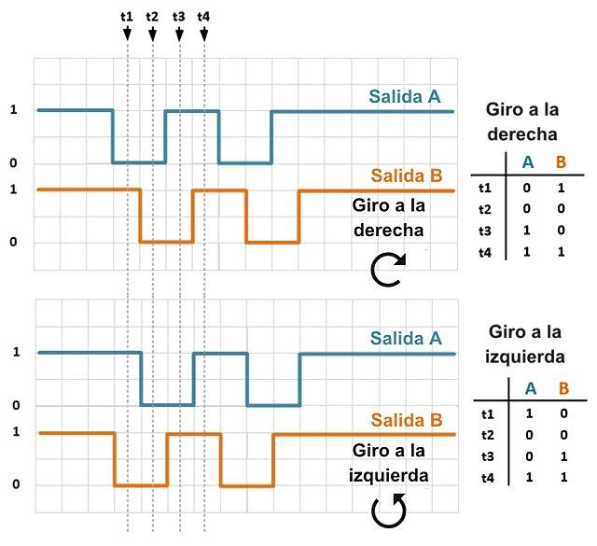
[picture p36: figure]

Source:https://th.bing.com/th/id/R.01cf5959a329601a70316d1d934d9806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 (https://th.bing.com/th/id/R.01cf5959a329601a70316d1d934d9806?rik=hAzRjl8eRxrZyA&risl=&pid=ImgRaw&r=0)

Date de consultation (20/05/25)

Analyse

Quand on commence a tourner l’axe vers la droite, on observe que le signal À change d’e tat un peu avant le signal B. Par exemple, À passe a 0, puis B passe a 0 juste apre s, ensuite À repasse a 1 et B le suit un peu plus tard. Ce petit de calage entre les deux signaux permet de savoir que l’encodeur tourne dans un sens pre cis.
Si on tourne l’encodeur dans l’autre sens, c’est le signal B qui change d’e tat en premier, avant À.

Programme Test

#define CLK 2 // Broche d'horloge

#define DT 3 | // Broche de données

int counter = 0; | // Compteur pour suivre la rotation
int currentStateCLK;
int lastStateCLK;

void setup() {
pinMode(CLK, INPUT);
pinMode(DT, INPUT);

Serial.begin(9600);

// Lire l'état initial de la broche CLK lastStateCLK = digitalRead(CLK);

Serial.println("Test de l'encodeur rotatif KY-040"); }

void loop() {
// Lire l'état actuel de la broche CLK currentStateCLK = digitalRead(CLK);

// Si l'état a changé, l'encodeur a tourné
if (currentStateCLK != lastStateCLK) {
// Vérifier la broche DT pour déterminer le sens de rotation if (digitalRead(DT) != currentStateCLK) {
counter++;
} else {
counter--;
}

Serial.print("Compteur : "); Serial.println(counter);
}

// Sauvegarder le dernier état de CLK
lastStateCLK = currentStateCLK;
}}
Source :Comment utiliser l'encodeur rotatif KY-040 avec Arduino – 38-3D (https://38-3d.co.uk/fr/blogs/blog-38-3d-3/comment-utiliser-lencodeur-rotatif-ky-040-avec-arduino) Date de consultation (20/5/2025)

Lien QR code

5.5.1 Mesure de l’encodeur rotatif

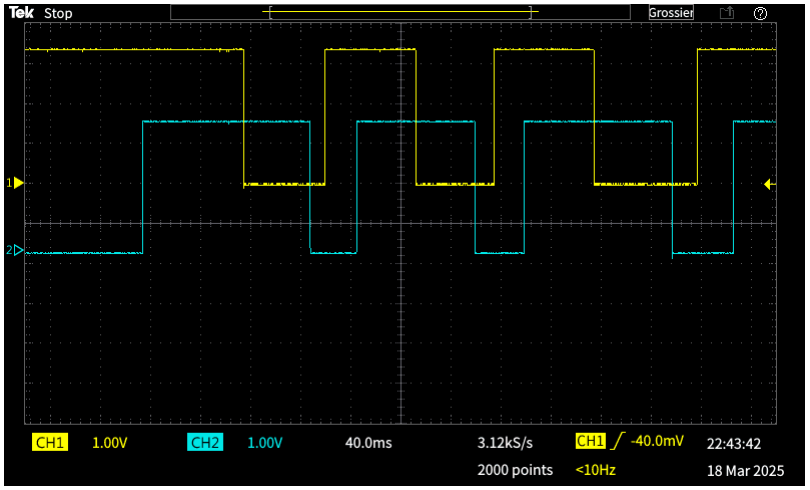
[picture p37: figure]

CLK : Jaune

DT : Bleu

T=40ms

Analyse

On remarque que quand on tourne l’encodeur, peu importe le sens, il sera de phase . Malheureusement, le SW de l’encodeur rotatif qui fait office de BP n’est pas mesure car je ne l’utilise pas dans mon projet. Selon la rotation effectue e, le de phasage ne s’effectue pas de la me me manie re, soit de 90° ou de -90°.
Si on veut calculer l’impulsion, il nous suffit de faire un petit calcul : 1/T = 1/0,040 s = 25 Hz. Cela signifie que l’encodeur ge ne re 25 impulsions par seconde, ce qui est
cohe rent avec les quelques sources trouve es sur l’encodeur rotatif, qui indiquent 20 impulsions par seconde.
Les rebonds ne sont pas pre sents sur les images, mais il peut y en avoir, et ils se distinguent par des variations rapides ou des signaux courts qui provoquent une fausse lecture de direction ou une multiplication des impulsions.

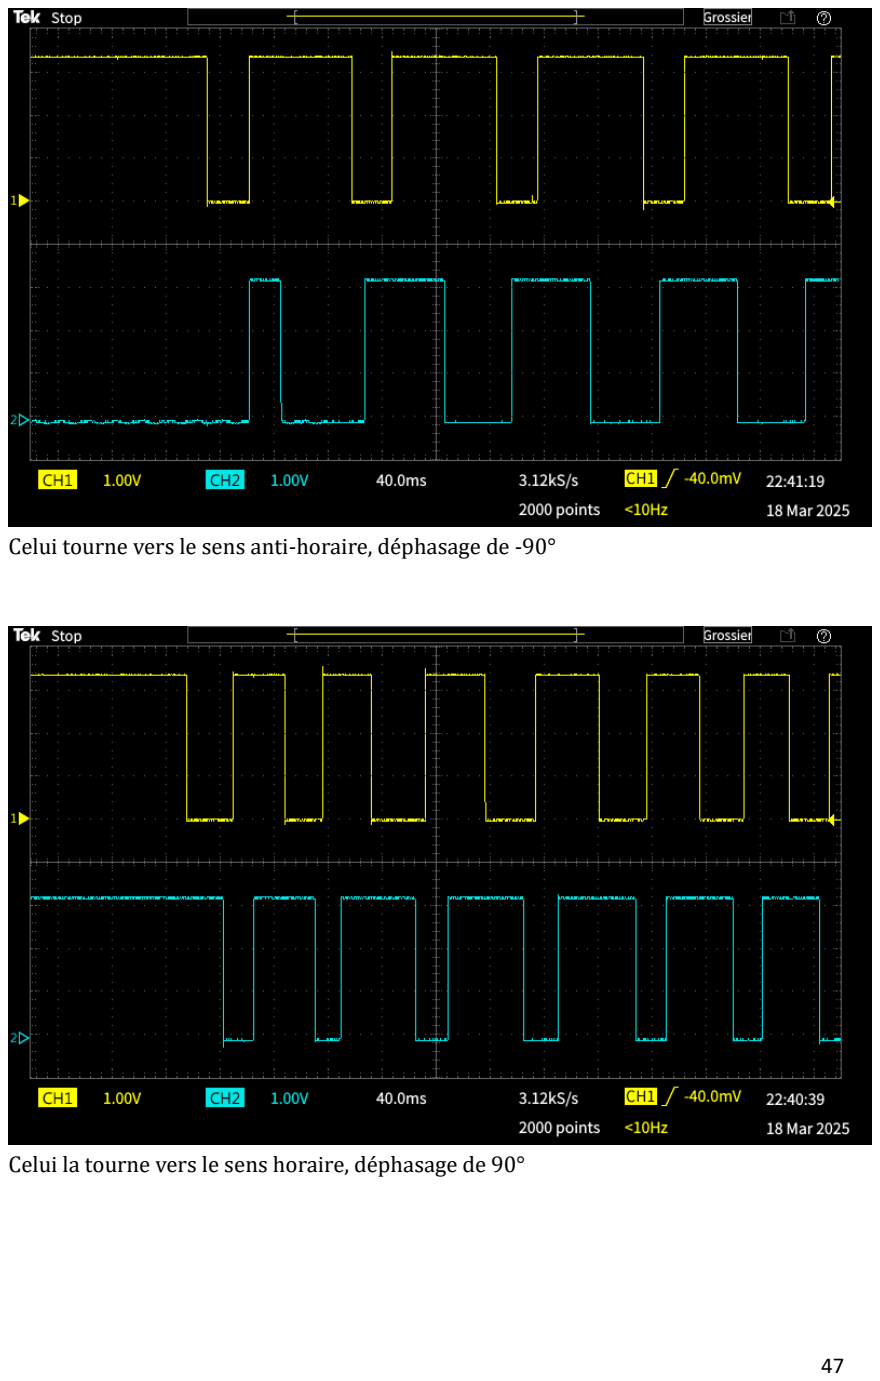
[picture p38: page 48]

Celui tourne vers le sens anti-horaire, de phasage de -90°

Celui la tourne vers le sens horaire, de phasage de 90°

## 6 La Programmation

## 6.1 L’ordinogramme général

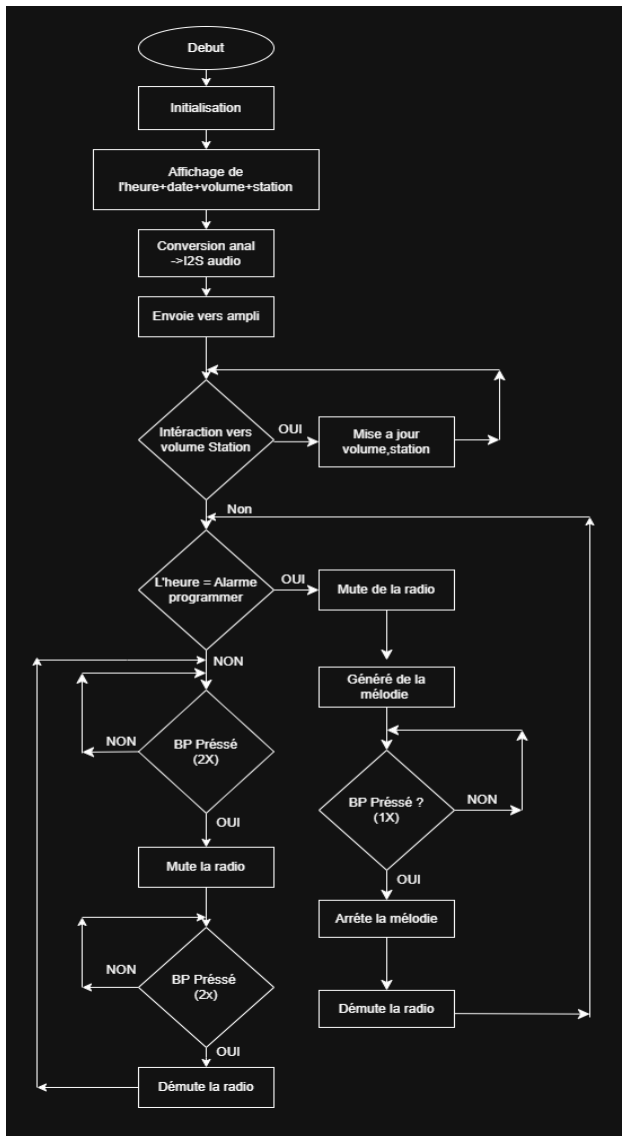
[picture p39: figure]

## 6.2 Le programme

#include "Peripherique.h"

RDA5807M radio;
RTC_PCF8523 rtc;
//*******************Variable Globale*******************************

Adafruit_ILI9341 tft = Adafruit_ILI9341(TFT_CS, TFT_DC, TFT_RST);

int Enregistre_CLK;
int Enregistre2_CLK;

int FREQUENCE_RADIO = 9000;
int VOLUME_RADIO = 12;
// ===================== Lecture des signaux rotatifs =====================
void Lecture_CLK(void) {
Enregistre_CLK = digitalRead(CLK);
Enregistre2_CLK = digitalRead(CLK1);
}
// ===================== Configuration des broches ===================== void Pin_Mode(void) {
pinMode(CLK, INPUT_PULLUP);
pinMode(DT, INPUT_PULLUP);
pinMode(CLK1, INPUT_PULLUP);
pinMode(DT1, INPUT_PULLUP);
}
// ===================== Initialisation de la radio ===================== void Initi_Radio(void) {//librairie
radio.initWire(Wire);
radio.setup(RADIO_FMSPACING, RADIO_FMSPACING_100); radio.setup(RADIO_DEEMPHASIS, RADIO_DEEMPHASIS_50);

radio.setBandFrequency(BANDE_RADIO, FREQUENCE_RADIO); /// parametre pas fixe
radio.setVolume(VOLUME_RADIO); | // parametre pas
fixe
radio.setMute(false);
radio.setMono(true);
}
// ===================== Réglage de la fréquence radio via encodeur =====================
void Station(void) { //mon idée, correction de la syntaxte(;.,)avec chat gpt
int Enregistre1_CLK = digitalRead(CLK);

if (Enregistre1_CLK != Enregistre_CLK) { if (digitalRead(DT) != Enregistre1_CLK) { FREQUENCE_RADIO += 10;
if (FREQUENCE_RADIO > 10800) FREQUENCE_RADIO = 8700;

} else {
FREQUENCE_RADIO -= 10;
if (FREQUENCE_RADIO < 8700) FREQUENCE_RADIO = 10800;
}

radio.setBandFrequency(BANDE_RADIO, FREQUENCE_RADIO); Serial.print("Fréquence: "); //TEST Serial.println(FREQUENCE_RADIO);
}

Enregistre_CLK = Enregistre1_CLK;
}
// ===================== Réglage du volume via encodeur =====================
void Volume(void) { /// MOI SEUL
int Enregistre3_CLK = digitalRead(CLK1);
if (Enregistre3_CLK != Enregistre2_CLK) { if (digitalRead(DT1) != Enregistre2_CLK) { VOLUME_RADIO += 1;
if (VOLUME_RADIO > 15)
VOLUME_RADIO = 15;
} else {
VOLUME_RADIO -= 1;
if (VOLUME_RADIO < 0)
VOLUME_RADIO = 0;
}
radio.setVolume(VOLUME_RADIO); Serial.print("Volume: ");
Serial.println(VOLUME_RADIO);
}
Enregistre2_CLK = Enregistre3_CLK;
}
// ===================== Lecture audio ===================== void Audio(void) {/// repris de chat gpt
int ADC_Gauche = analogRead(GAUCHE);
int ADC_Droite = analogRead(DROIT);

int16_t audioGauche = (ADC_Gauche - 275) * 64; // echantilloner sur 16 bits recentrée sur 0 puis amplifier 275 son de qualitée
int16_t audioDroite = (ADC_Droite - 275) * 64; I2S.write(audioGauche);
I2S.write(audioDroite);

}
// ===================== Initialisation de la sortie audio I2S =====================
void Initi_Ampli(void) {///librairie
I2S.begin(I2S_PHILIPS_MODE, 44100, 16); // Initialisation de l'I²S mode Philips, 44.1 kHz, 16 bits44100
}
void Initi_Ecran(void){
tft.begin();
tft.setRotation(1);
tft.fillScreen(ILI9341_BLACK);

}

Code radio au stade actuelle 23/25/25

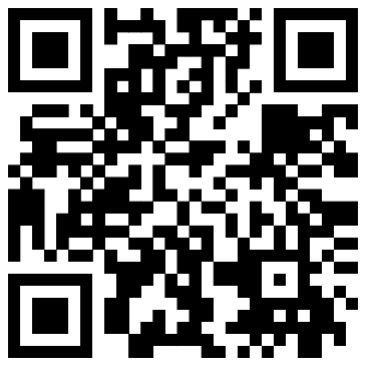
[picture p40: figure]

Lien GitHub de mon code

Code_TFE_MPL/Code_TFE_MPL.ino at main · MatheoPatinoLoya/Code_TFE_MPL (https://github.com/MatheoPatinoLoya/Code_TFE_MPL/blob/main/Code_TFE_MPL.ino)

## 7 La fabrication

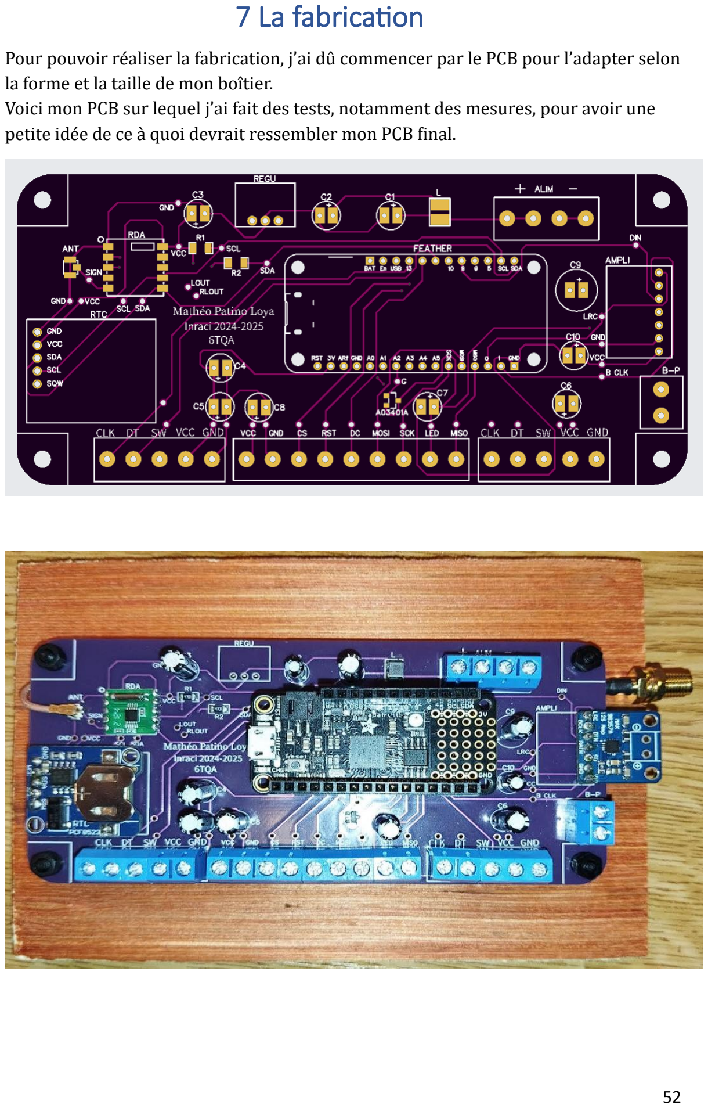
[picture p41: page 53]

Pour pouvoir re aliser la fabrication, j’ai du commencer par le PCB pour l’adapter selon la forme et la taille de mon boî tier.
Voici mon PCB sur lequel j’ai fait des tests, notamment des mesures, pour avoir une petite ide e de ce a quoi devrait ressembler mon PCB final.

Pour avoir une vue d’ensemble et un peu imaginer mon boitier ide al j’ai utilise Solidwork2013 dans lequel j’ai assemble mon boitier et mon Pcb.

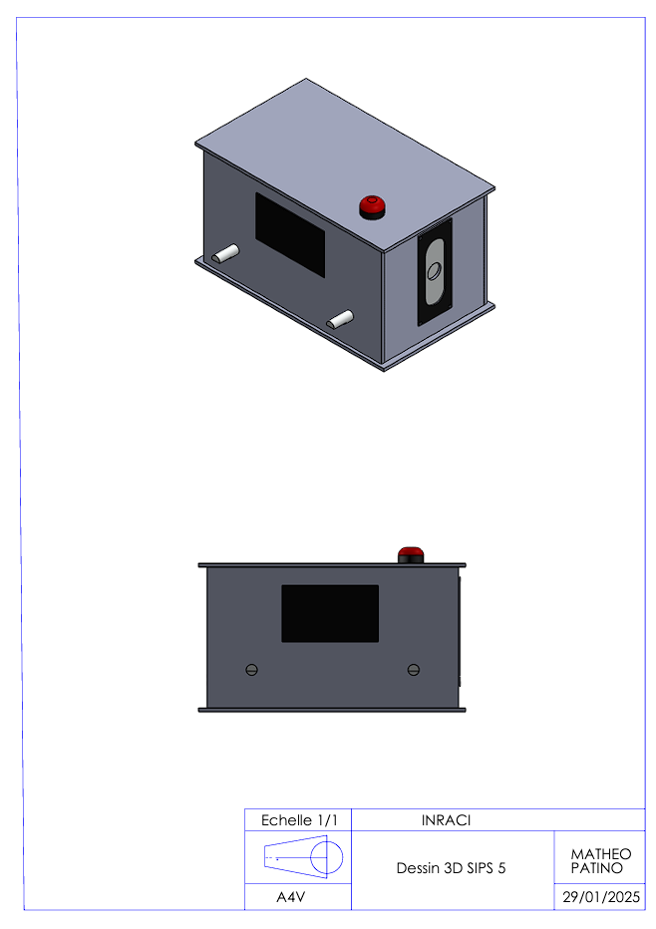
[picture p42: figure]

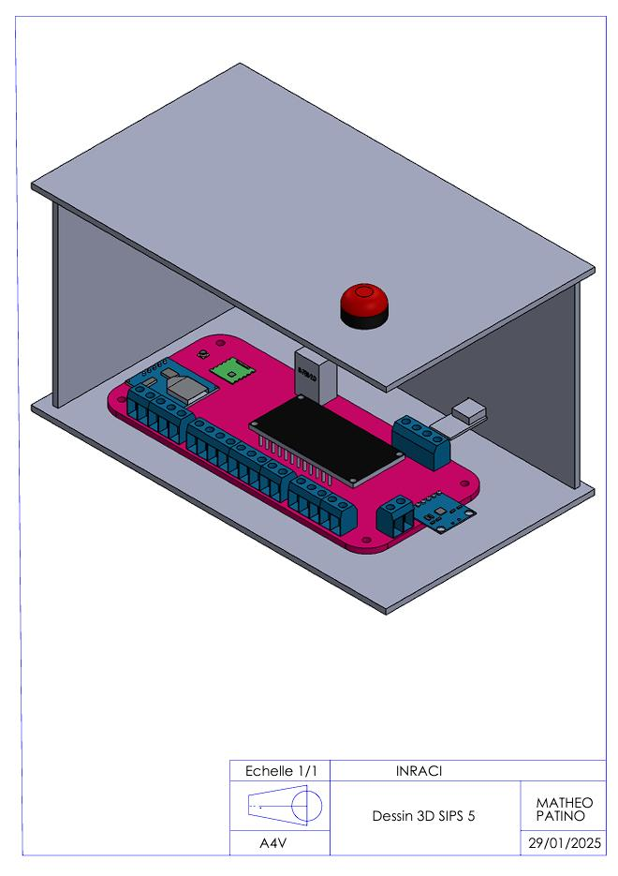
[picture p43: figure]

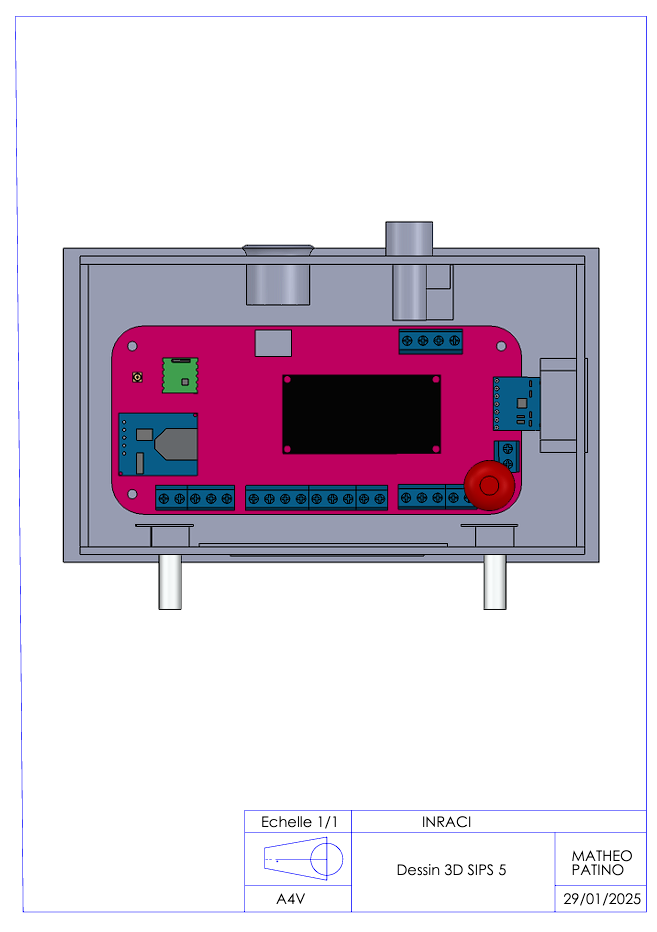
[picture p44: figure]

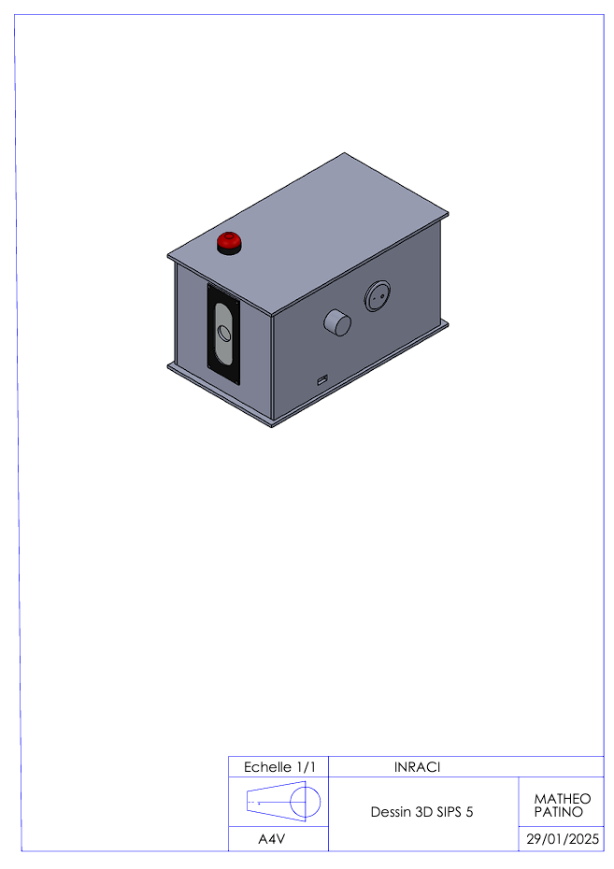
[picture p45: figure]
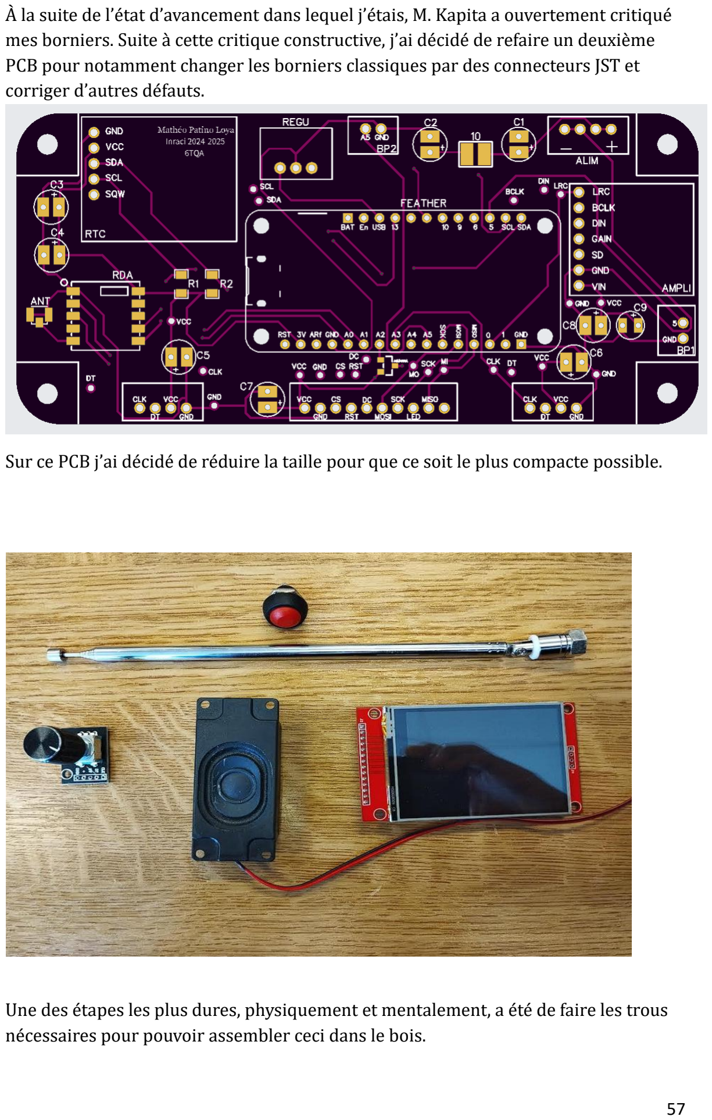
[picture p46: page 58]

À la suite de l’e tat d’avancement dans lequel j’e tais, M. Kapita a ouvertement critique mes borniers. Suite a cette critique constructive, j’ai de cide de refaire un deuxie me PCB pour notamment changer les borniers classiques par des connecteurs JST et corriger d’autres de fauts.

Sur ce PCB j’ai de cide de re duire la taille pour que ce soit le plus compacte possible.

Une des e tapes les plus dures, physiquement et mentalement, a e te de faire les trous ne cessaires pour pouvoir assembler ceci dans le bois.

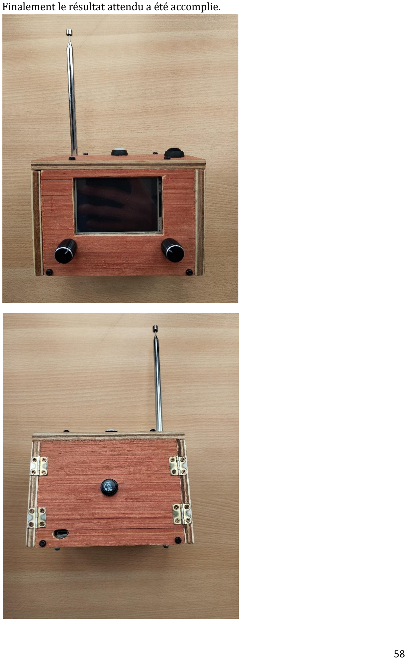
[picture p47: page 59]

Finalement le re sultat attendu a e te accomplie.

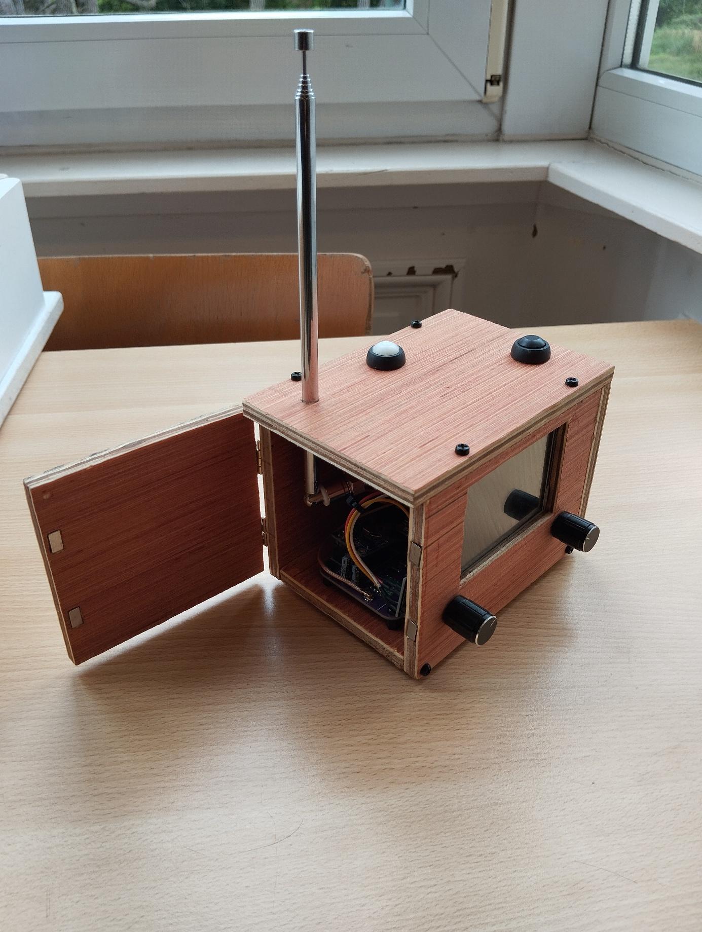
[picture p48: figure]

Pour finir l’e tat final est satisfaisant, je devrai encore l’ame liorer car l’esthe tique est vraiment son point faible, mais avant tout mon but a e te de le faire en bois pour avoir une radio vintage, donc aucun regret.

## 8 La mise en point

Durant la re alisation de mon projet, j’ai rencontre de nombreux soucis en cours de route, aussi bien au niveau du hardware que software.

Les mesures de l’écran spi

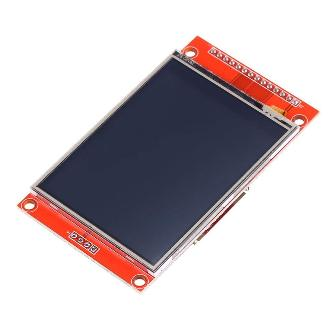
[picture p49: figure]

Mesure

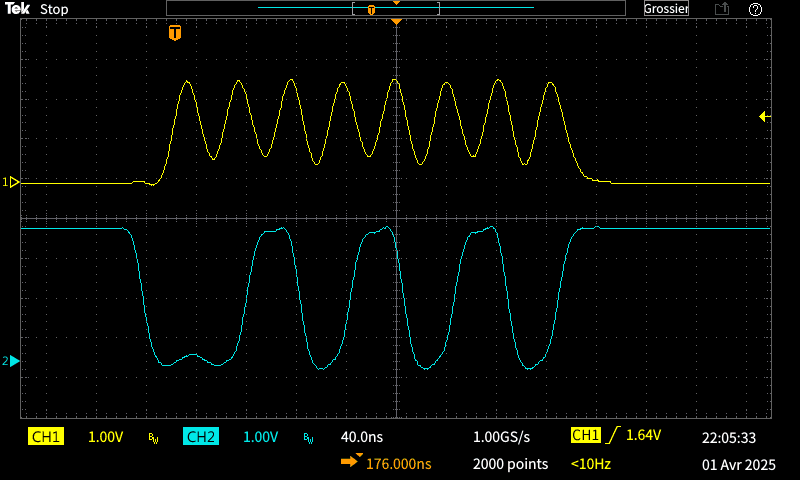
[picture p50: figure]

Jaune : SCK

Bleu : Mosi

Analyse

Sur cette image, on constate que les signaux ressemblent plus a des sinus qu’a un signal carre , par conse quent impossible d’avoir une trame de donne e lisible et correcte. La cause de ce proble me est la limitation de l’oscilloscope et de la sonde.

En sachant que la pe riode est de 40 ns, la fre quence est de 25 MHz.

Cette distorsion est principalement due a la bande passante limite e de la sonde (50 MHz), qui ne permet pas de capturer correctement les harmoniques pre sentes dans un signal carre . Un signal carre contient une fondamentale ainsi que des multiples harmoniques impairs. Donc, si la fondamentale est de 25 MHz et que la sonde a une bande passante limite e a 50 MHz, l'harmonique qui suit est de 75 MHz, ce qui de passe la bande passante de la sonde. Donc la sonde filtre les harmoniques et ne laisse passer que la fondamentale 25 MHz, ce qui correspond a une forme sinusoî dale.

De plus, la limitation de l’oscilloscope pose un proble me, car si la bande passante de celui-ci est de 50 MHz, alors il ne peut afficher les fre quences supe rieures a 50 MHz. Or un signal carre contient des harmoniques impairs, ce qui donne une mauvaise image du signal et le lisse.

La solution pour re gler ce proble me est d’avoir une sonde avec une bande passante supe rieure a la fre quence du signal, et aussi un oscilloscope avec la bande passante la plus e leve e possible.

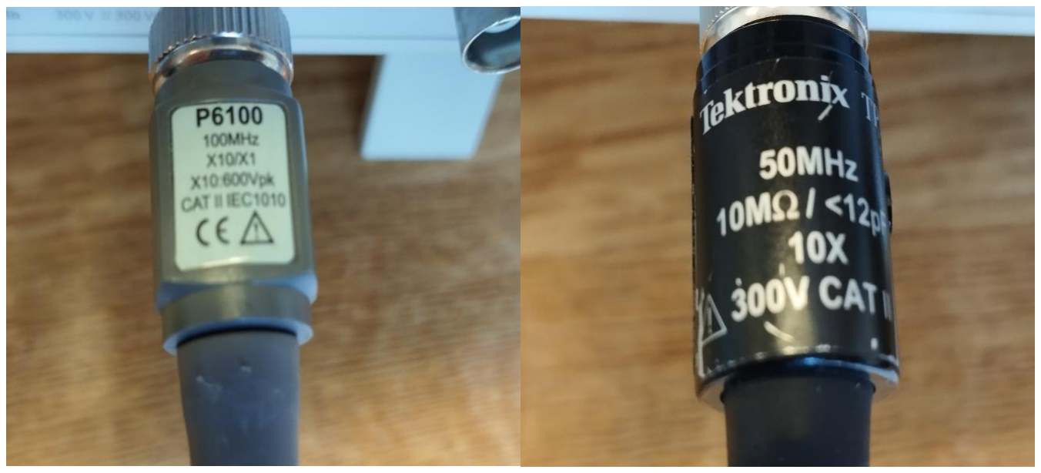
[picture p51: figure]

On constate qu’une des sondes ici est de 100 MHz et l’autre est de 50 MHz. Le signal jaune a été mesuré par la sonde à 50 MHz, et le signal bleu par celle de 100 MHz. Si on revient sur l’image, on remarque que le signal bleu ressemble moins à un sinus comparé à l’autre. Ceci est dû à la sonde qui a une bande passante plus élevée, par conséquent, elle laisse passer plus d’harmoniques du signal carré.

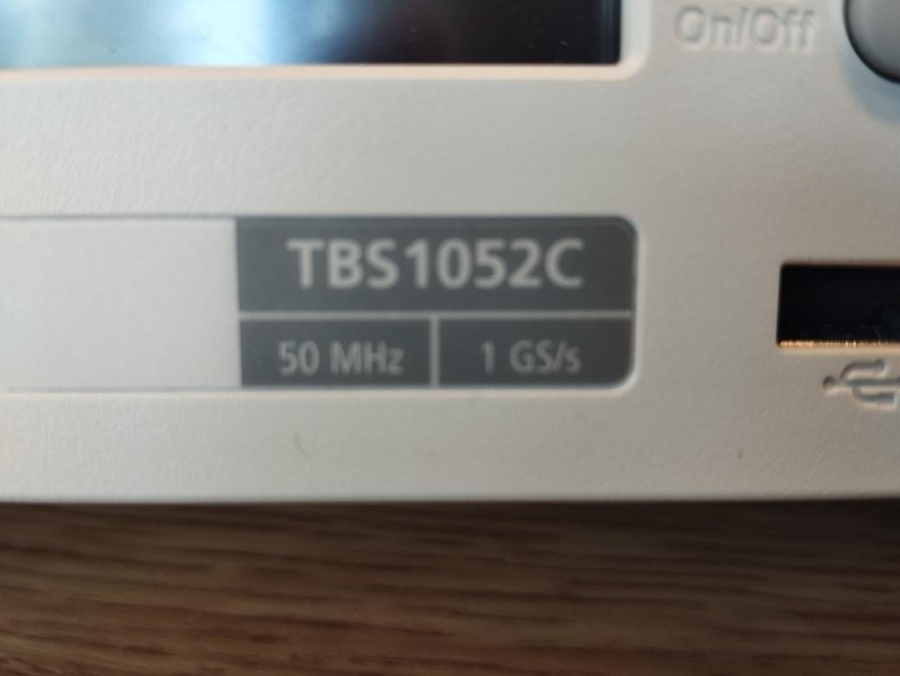
[picture p52: figure]

50Mhz correspond à la bande passant de l’oscilloscope (max)

1GS/S correspond à la fréquence d’échantillonnage (max)

Conception du boitier

J’ai eu un petit proble me lors de la conception du boî tier en bois, car a la base mon boî tier devait rester ferme sans aucun moyen de l’ouvrir, ce qui fait que on ne pourrait jamais voir mon beau PCB et mon ca blage.

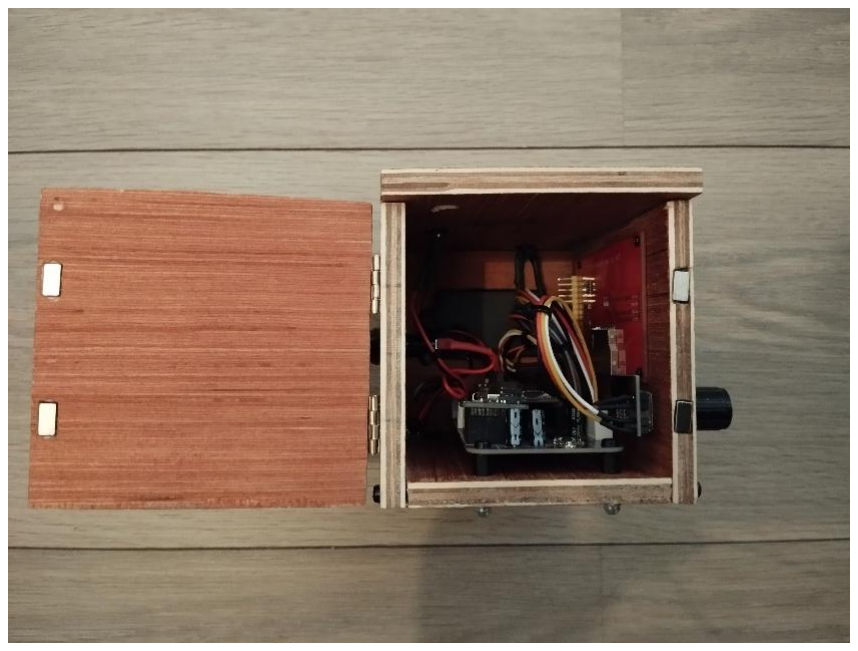
[picture p53: figure]
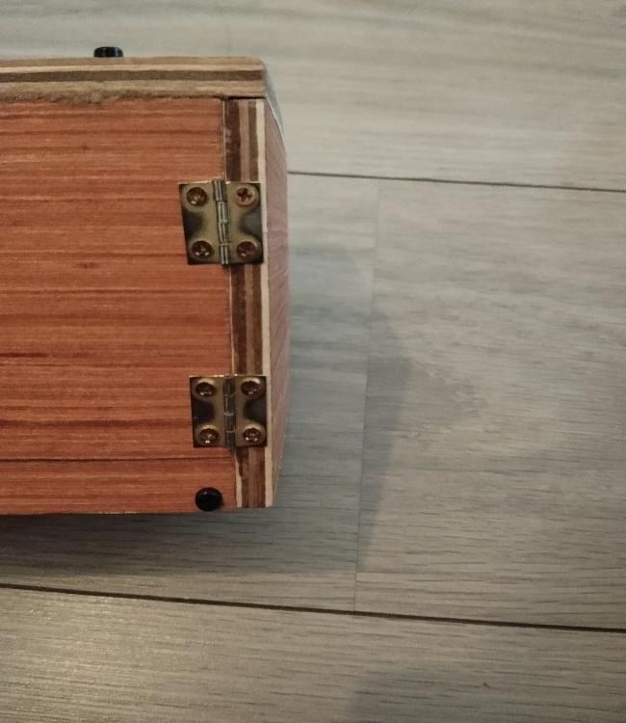
[picture p54: figure]

Une des solutions a e te de cre e e une petite porte pour pouvoir acce der de l’inte rieure de mon boitier a l’aide de charnie re et d’aimant.

Conflit de librairie

Dans le cadre de mon projet, la partie software a aussi e te un gros obstacle. En effet, j’ai eu un proble me de librairie de deux bibliothe ques qui utilisaient la me me fonction appele e zero_dmac_handler, ce qui empe chait mon code de se compiler.
De base la fonction zero_dmac_handler() sert a ge rer les interruptions ge ne re es par le contro leur sur les microcontro leurs SÀMD21.

La solution a e te de changer le nom de la fonction dans un des fichiers .cpp, pour qu’il n’y ait plus de soucis. Une fois cette modification faite, le code s’est compile sans proble me.
Bien su r, M. Kapita m’a aide a re gler ce souci, parce que c’e tait trop complique pour un simple de butant comme moi. Sans son aide, j’aurais eu beaucoup de mal a
comprendre comment changer l’erreur, malheureusement je n’ai pas de pris de photo de l’erreur de compilation.

## 9 La conclusion

Dans un premier temps la partie me canique, assemblage a e te finaliser avec succe s me me s’il reste des petites ame liorations esthe tiques de mon
boitier Malheureusement, la partie programmation a e te une e preuve difficile. Àu de but de mon projet, j’e tais un peu perdu, notamment pour la mise en commun des diffe rents modules, Ducoup j’ai accumuler du retard et la programmation actuelle du re veil n’a pas encore de buter.

Le plus important c’est que j’ai avance sans jamais abandonner me me si au de but je ne savais pas comment m’y prendre car c’e tait un domaine encore inconnu puisque a l’inraci il n’y plus de cour de Te le communication. Mais pour y arriver j’ai du me renseigner au sujet de tout, datasheet des composant, librairie, etc. Grace a messieurs Mr kapita je n’ai pas perdu mon chemin et j’ai pu continuer mon projet avec plus de confiance et de clarte .

Àvant tous ces difficulte s ont e te tre s enrichissante j’ai compris l’importance de mieux s’organiser, de se documenter et de ne pas trop de pendre de chat GPT.

Finalement si tout ne s’est pas passe comme je l’espe rais, je suis satisfait du chemin parcouru, car cette expe rience m’a permis d’apprendre de mes erreurs et m’a donne de bonnes bases pour mes futurs projets.

## Bibliographie

Librairie

Source : adafruit/Adafruit_ZeroI2S: I2S audio playback library for the Arduino Zero / Adafruit Feather M0 (SAMD21 processor). (https://github.com/adafruit/Adafruit_ZeroI2S)

Date de consultation (2/10/2024)

Source : GitHub - mathertel/Radio : Une librairie Arduino pour contrôler les puces radio FM comme SI4703, SI4705, RDA5807M, TEA5767. (https://github.com/mathertel/Radio)

Date de consultation (5/10/2024)

Source : pu2clr/RDA5807: Arduino Library for SINGLE-CHIP BROADCAST FM RADIO TUNER RDA5807 (https://github.com/pu2clr/RDA5807)

Date de consultation (8/10/2024)

Source : adafruit/Adafruit_ILI9341: Library for Adafruit ILI9341 displays (https://github.com/adafruit/Adafruit_ILI9341)

Date de consultation (15/10/2024)

Source : adafruit/Adafruit-GFX-Library: Adafruit GFX graphics core Arduino library, this is the 'core' class that all our other graphics libraries derive from (https://github.com/adafruit/Adafruit-GFX-Library)

Date de consultation (18/10/2024)

Source : GitHub - adafruit/RTClib: A fork of Jeelab's fantastic RTC Arduino library (https://github.com/adafruit/RTClib)

Date de consultation (24/10/2024)

Datasheet

Source : adafruit-max98357-i2s-class-d-mono-amp.pdf (https://cdn-learn.adafruit.com/downloads/pdf/adafruit-max98357-i2s-class-d-mono-amp.pdf)

Date de consultation (15/11/2024)

Source : MAX98357A/MAX98357B - Tiny, Low-Cost, PCM Class D Amplifier with Class AB Performance (https://www.analog.com/media/en/technical-documentation/data-sheets/MAX98357A-MAX98357B.pdf)

Date de consultation(12/11/2024)

Source : KY-040 Datasheet(PDF) - JOY-IT (https://www.alldatasheet.com/datasheet-pdf/pdf/1648739/JOY-IT/KY-040.html)

Date de consultation(2/2/2025)

Source : RDA5807M Datasheet(PDF) - RDA Microelectronics, Inc (https://www.alldatasheet.com/datasheet-pdf/pdf/1741404/RDA/RDA5807M.html)

Date de consultation(13/12/2024)

Source : R-78E-0.5.pdf (https://recom-power.com/pdf/Innoline/R-78E-0.5.pdf)

Date de consultation(2/3/2025)

Source : UMW AO3401A (https://mm.digikey.com/Volume0/opasdata/d220001/medias/docus/2969/UMW%20AO3401A.pdf)

Date de consultation(26/3/2025)

Sources d’information

Source : Wikipedia (https://www.wikipedia.org/)

Date de consultation (1/10/2024 - 26/05/2025)

Source : ChatGPT (https://chatgpt.com/)

Date de consultation (1/10/2024 – 26/05/2025)

Source : Simple FM Radio Receiver With Arduino UNO and RDA5807M | Arduino |
Maker Pro (https://maker.pro/arduino/projects/simple-fm-radio-receiver-with-arduino-uno-and-rda5807m)

Date de consultation (7/10/2024)

Source : Radio fm basée sur Arduino utilisant rda5807 - l'audio 2025 (https://fr.amen-technologies.com/arduino-based-fm-radio-using-rda5807)

Date de consultation (8/4/2025)

Source : Arduino RDA5807M FM Receiver (https://www.circuits-diy.com/arduino-rda5807m-fm-receiver/)

Date de consultation (20/11/2024)

Source : Radio FM audio numérique basée sur Arduino utilisant RDA5807 : 15 étapes - Instructables (https://www.instructables.com/Arduino-Based-Digital-Audio-FM-Radio-Using-RDA5807/)

Date de consultation (2/5/2025)

Source : Module SPI 2,8 pouces ILI9341 SKU :MSP2807 - Wiki LCD (http://www.lcdwiki.com/2.8inch_SPI_Module_ILI9341_SKU:MSP2807)

Date de consultation (9/1/2025)

Source : Comment utiliser l'écran ILI9341 avec Arduino - Tutoriel complet et détaillé (https://fr.hwlibre.com/comment-utiliser-l%27%C3%A9cran-ili9341-avec-arduino-tuto-complet-et-d%C3%A9taill%C3%A9/) date de consultation(26/1/2025)

Source : Encodeur rotatif : fonctionnement + exemples de code arduino (https://passionelectronique.fr/encodeur-rotatif-incremental-mecanique/)

Date de consultation (27/1/2025)

Source : Encodeur rotatif KY-040 | Modules et senseurs avec Arduino (https://ledisrupteurdimensionnel.com/arduino/modules-et-capteurs/encodeur-rotatif-ky-040/)

Date de consultation (28/1/2025)

Source : I2S Library Examples | Arduino Documentation (https://docs.arduino.cc/tutorials/generic/I2s-library-examples/)

Date de consultation (13/5/2025)

## Les annexes

## Schéma de principe sans connecteur

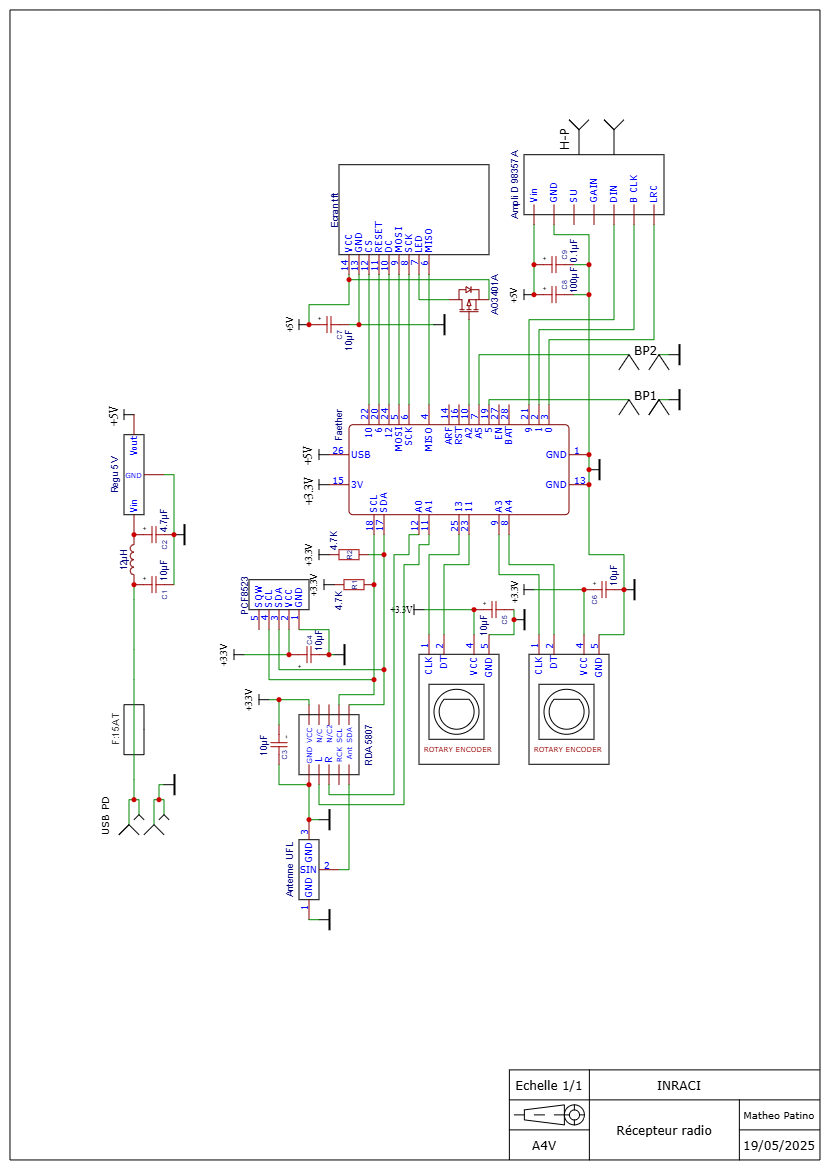
[picture p55: figure]

## PCB Sérigraphie V1

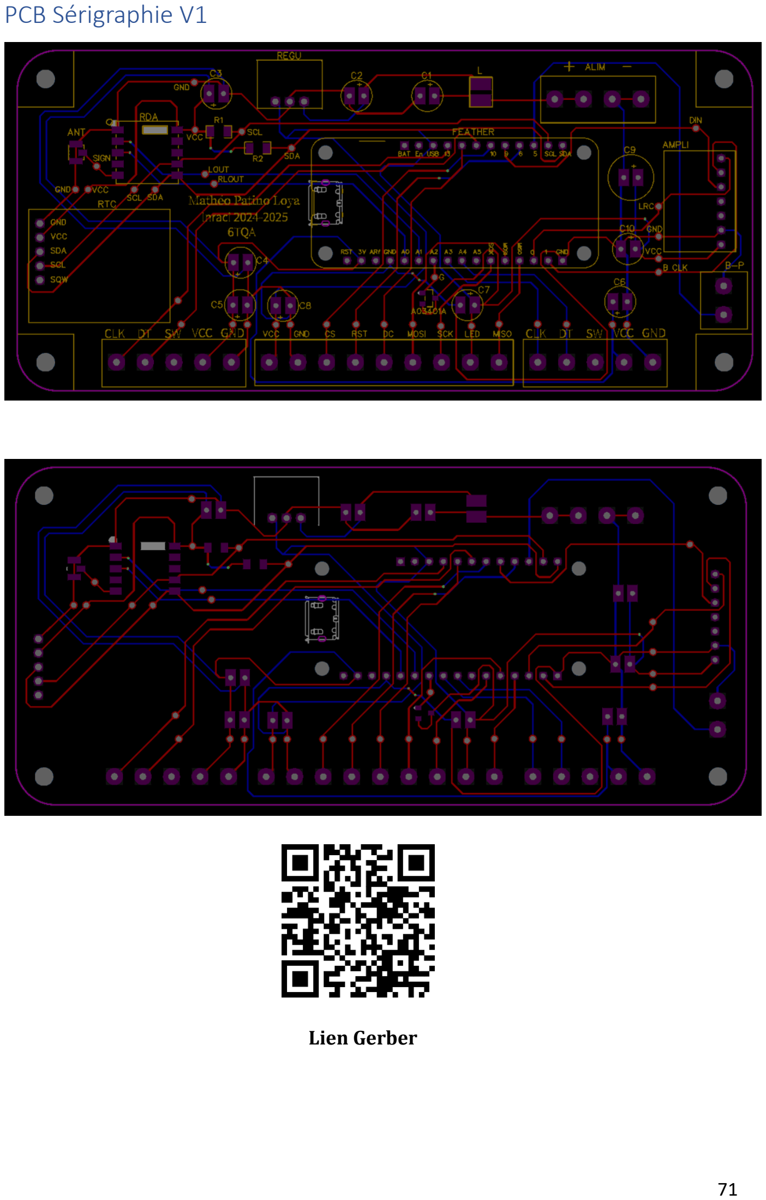
[picture p56: page 72]

Lien Gerber

## PCB Sérigraphie V2

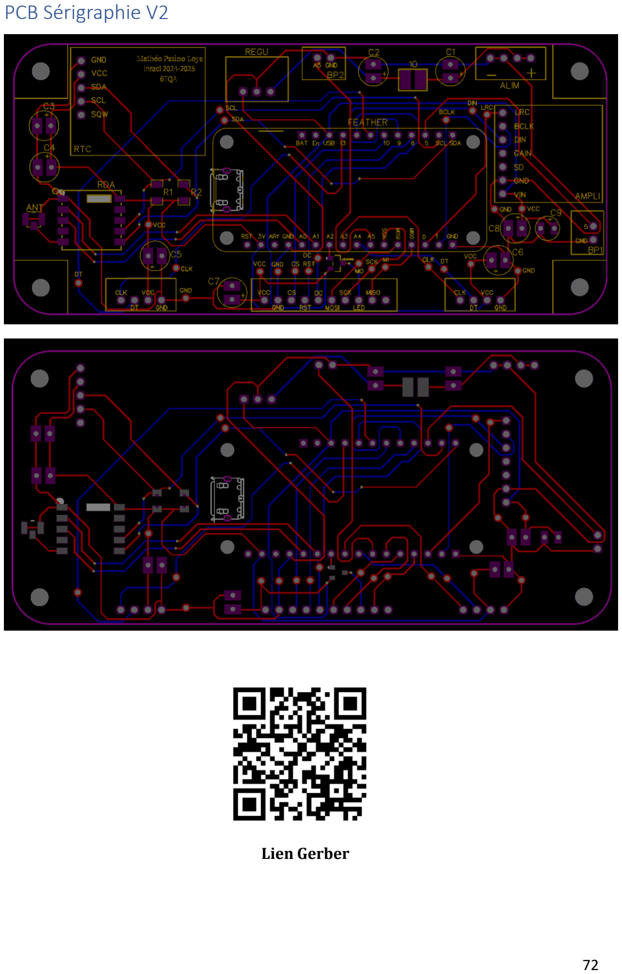
[picture p57: page 73]

Lien Gerber

## Croquis

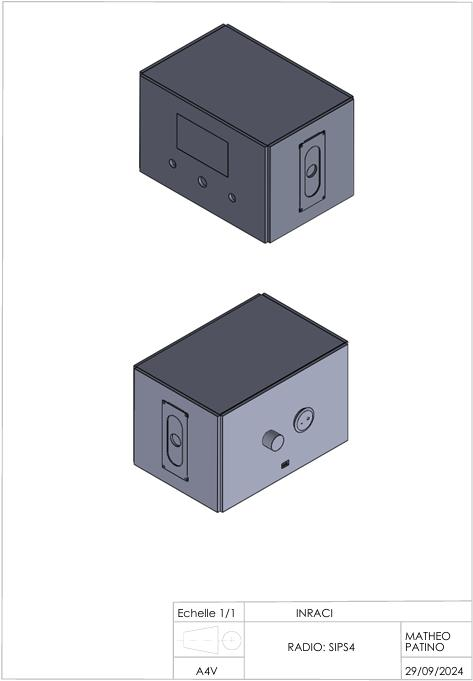
[picture p58: figure]

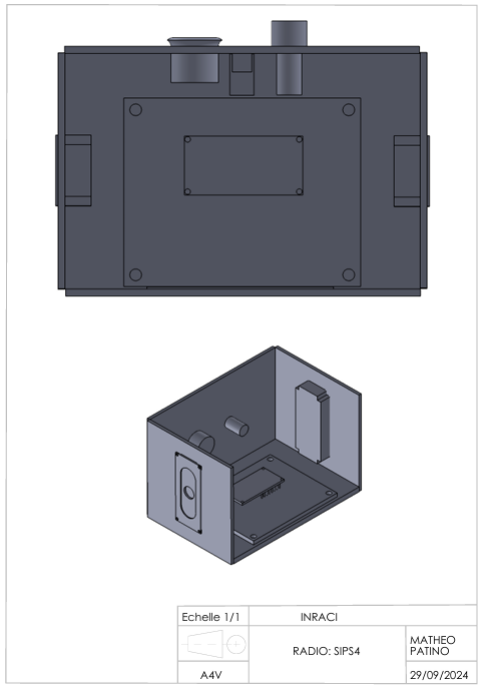
[picture p59: figure]

## Liste du matériel

Régulateur 5V : R-78E5.0-0.5 Recom Power | Alimentations à montage sur carte | DigiKey (https://www.digikey.be/fr/products/detail/recom-power/R-78E5-0-0-5/2834904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)
Bobine : RLS-126 Recom Power | Inductances, bobines, bobines d'arrêt | DigiKey (https://www.digikey.be/fr/products/detail/recom-power/RLS-126/9920565)
Connecteur UFL : U.FL-R-SMT-1(10) Hirose Electric Co Ltd | Connecteurs, interconnexions |
DigiKey (https://www.digikey.be/fr/products/detail/hirose-electric-co-ltd/U-FL-R-SMT-1-10/2391570)
Resistance : RC1206FR-074K7L YAGEO | Résistances | DigiKey (https://www.digikey.be/fr/products/detail/yageo/RC1206FR-074K7L/728887)
Transistor :AO3401A UMW | Produits semi-conducteurs discrets | DigiKey (https://www.digikey.be/fr/products/detail/umw/AO3401A/16705973)

Ecran : Hailege 2.8" ILI9341 240 * 320 TFT Écran LCD Écran Tactile SPI Série 5V / 3.3V Raspberry Pi STM32 : Amazon.com.be: Industrie et science (https://www.amazon.com.be/Hailege-ILI9341-%C3%89cran-Tactile-Raspberry/dp/B07YTWRZGR)

Encodeur linéaire : QWORK Lot de 5 KY-040 360 Degree Rotatif Encodeur Module avec Capuchon de Bouton pour Arduino : Amazon.com.be: Industrie et science (https://www.amazon.com.be/QWORK-Rotatif-Encodeur-Capuchon-Arduino/dp/B09R41C1HR)

Bouton poussoir :Gebildet 12pcs 12mm Étanche Momentané Bouton Poussoir SPST ON/OFF 3A/3V-5V-9V-12V-24V-230VAC, Déblocable Rond Bouton,pour Trompette de Voiture, PC, Lampe de Table, Sonnette de Maison : Amazon.com.be: Auto et moto (https://www.amazon.com.be/Gebildet-Momentan%C3%A9-3V-5V-9V-12V-24V-230VAC-D%C3%A9blocable-Trompette/dp/B07XQSBW7Q)

Fusible :10 Pièces 10a 250 V Porte-fusible Montage sur Panneau 5 X 20mm Porte-fusible Bouchon à Vis pour équipement électrique et Motos : Amazon.com.be: Auto et moto (https://www.amazon.com.be/Porte-fusible-Montage-Panneau-%C3%A9quipement-%C3%A9lectrique/dp/B08FX8K5K4)

Cable coaxial : TUOLNK IPX MHF1 vers SMA, câble coaxial SMA femelle vers U.FL IPX RG178 pour module GPS Mini PCI UFL vers SMA WiFi Câble d'extension d'antenne 10 cm 5 pièces : Amazon.com.be: High-tech (https://www.amazon.com.be/TUOLNK-coaxial-femelle-dextension-dantenne/dp/B0B9RYL56H)

RTC : Hailege PCF8523 Real Time Clock RTC Breakout Module PCF8523 Real Time Clock Assembled Breakout Board 3.3V 5V Time Clock for Arduino : Amazon.com.be: Industrie et science (https://www.amazon.com.be/Hailege-PCF8523-Breakout-Assembled-Arduino/dp/B0836M8F1H)

Module radio : Lot de 10 modules radio FM stéréo RDA5807M RRD-102V2.0 sans fil 2,7-3,6 V 76-108 MHz pour téléphone portable, ordinateur portable et MP3 : Amazon.com.be: High-tech (https://www.amazon.com.be/RDA5807M-RRD-102V2-0-t%C3%A9l%C3%A9phone-portable-ordinateur/dp/B0D2L57QTN)

Ampli Max 98357A :Adafruit I2S 3W Class D Amplifier Breakout - MAX98357A [ADA3006] : Amazon.com.be: High-tech (https://www.amazon.com.be/Adafruit-I2S-Class-Amplifier-Breakout/dp/B01K5GCFA6)

Condensateur Voarge Lot de 500 condensateurs électrolytiques 24 valeurs, condensateur électrolytique 0.1uF-1000uF, lot de différents assortiments noir avec boîte en plastique transparent : Amazon.com.be: Industrie et science (https://www.amazon.com.be/Voarge-condensateurs-%C3%A9lectrolytiques-condensateur-%C3%A9lectrolytique/dp/B08GFJ2D5K)

Connecteur JST : Connecteurs ZH 1,5 mm et câbles en silicone pré-sertis 28 AWG compatibles avec connecteur JST ZH 1,5 2/3/4/5/6/7/8/9/10 broches avec câble adaptateur de boîtier de 160 mm de long : Amazon.fr: High-Tech (https://www.amazon.fr/Connecteur-silicone-pr%C3%A9-sertis-connecteur-adaptateur/dp/B0C6WY7DZM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)

Antenne : Vecys Lot de 2 antennes radio FM portables télescopiques pour radio TV, réception stéréo FM/AM, 8 sections : Amazon.com.be: High-tech (https://www.amazon.com.be/Vecys-antennes-portables-t%C3%A9lescopiques-r%C3%A9ception/dp/B09681L679)
