MatheoPatinoLoya/Code_TFE_MPL/Code_TFE_MPL.ino

//*******************************************************************
//  Programme : Fonctionnement de la Radio
//  Auteur : MATHEO PATINO LOYA 6ème Electronique INRACI
//  Hardware : Faether M0 Express + RDA5807M + PCF 8523 + MAX 98357A + KY-040 + 2.8 TFT 240*320 +
//  Date : 04/07/2024
//********************************************************************

#include "Peripherique.h"

void setup() {
  Serial.begin(9600);
   Initi_Ampli();
   Initi_Radio();
   Pin_Mode();
   Lecture_CLK();
   Initi_Ecran();
}

void loop() {
   Station();
   Volume();
   Audio();
  BP_Blanc();

}
