MatheoPatinoLoya/Code_TFE_MPL/(commit log)

2025-02-23 Broche+libraire des composant
    23/02/2025
2025-02-23 RTC initialisation
    debut du la mise en commun rtc+ampli+module
2025-02-28 initialisation encodeur ,volume
    probleme : 2 libraire son en conflit a cause du dmac_handler
    [Code_TFE_MPL.ino]
2025-03-03 sauvegarde
    encodeur g ,change les station fm
2025-03-04 fin encodeur lineaire
    encodeur lineaire finit ,le gauche augmente et diminue de volume et le droit change de station
2025-03-06 mise en ordre du code
    remise en ordre serial print , etc
2025-03-09 utulisation des fonctions
    3 fonctions ,volume,station,audio
    fonction a ajouter en cours
2025-03-12 Creation de mes fonction .h et .cpp
    volume station et audio =sans valeur d'entrée et sans valeur de sortie
2025-03-12 Fonction ajouter
    afficher le volume et afficher la station =avec valeur d'entrée, mais sans valeur de sortie.
    avec valeur de sortie, mais sans valeur d'entrée
2025-03-13 ajout de 2 fonction
    bool initi + Pin Mode =sans valeur d'entrée et sans valeur de sortie ,avec valeur de sortie et au moins une valeur d'entrée.
2025-03-30 PCB IMAGE
    ne pas oublier le fichier giber a mettre dans le github
2025-04-01 badge HTML
    rajout des 3 badges HTML par Achraf El Amrani
2025-04-10 Ecran +Ampli+Radio
    probleme de conflit de librairie régler par messieur kapita
    [Code_TFE_MPL.ino, Peripherique.cpp, Peripherique.h]
2025-04-13 Mise en ordre
    fonction ajouter + retirer externe
    Prochain comit afficher le volume et la sation sur l'ecran spi
2025-04-14 Affichage volume et station (SPI)
    Ne pas oubliez de crée une fonction pour l'initialisation de l'ecran et pour le prochain code essayer de mettre le l'heure sur l'ecran
2025-04-17 Affichage Heure Date Jour (spi)
    probleme : ne fonctionne pas quand les deux communique sur le meme bus en meme temps ,le rtc coupe le son de mon module radio
    Prochain commit ; regler ce probleme
    [Code_TFE_MPL.ino, Peripherique.cpp, Peripherique.h]
2025-05-02 correction schema de principe
    mise a jour de mon schema de principe corriger
2025-05-02 Nv PCB
    mise a jour du nv pcb
2025-05-21 Mise en page Tête d'affiche
    Solution pour regler le probeme si j'apuie sur bp on m'affiche l'heure la date et jour
2025-05-22 Mise en ordre
    usage constant de chat gpt ducoup recommencer jusqu'a ce que ça rentre dans tete et savoir expliquer mon code
2025-05-22 Ajout de l'ecran
    Code a ma maniere avec ma logique meme si c'est nul
2025-05-28 TFE_PDF
    -Ajout du TFE en PDF par Achraf
    -Reglage de programme + avancement sur l'écran
2025-06-09 amelioration github
    ajout de photo
